promerogomb/Lanzadera-Electromagnetica/Memoria/Aux/EcsBlancas.pdf

Ley Integral de Amp`ere
I
B⃗ · d

⃗l = µ0Ienc

∇ · ⃗ E⃗ =

ρ
ϵ0

∇ · ⃗ B⃗ = 0

∇×⃗ E⃗ = −

∂B⃗
∂t ∇×⃗ B⃗ = µ0J⃗+µ0ϵ0

∂E⃗

∂t

∇×⃗ B⃗ = µ0J⃗+µ0ϵ0

| ∂E⃗
| ∂t →

I
| B⃗ ·d ⃗l = µ0Ienc

B = µ0µr

NI
L

= NI

=

lcarac

µ0µrSeff

= F/R

1

Rϕ =

(lc + lfe) − x

µ0 ∗ Sdisp

Rfe =

lfe

µ0µr ∗ Sfe

Rdisp c =

lc

µ0 ∗ Sdisp

Raire c =

lc − x

µ0 ∗ Sc

XR = Rϕ+Rfe+Rdisp c+Raire c → ϕ =

NI
PR

BT =

ϕ
ST

→ FT =

1
2

B²
T

∗ ST
µ0

Tsim = 25 ms Tstep = 1 ms → 25 steps

I(t = 0) = 3,5 A I(t ≥ 15 ms) = 0 A Vcoil = 13,1 V Rcoil = 3,65 Ω mbar = 0,019 kg vbar ini = 0 ms⁻¹

2

d(t) = 1
2

at² + v0t + d0 → d =

1
2

at² →

→ a =

2d
t

2 → F = ma

3
