promerogomb/Lanzadera-Electromagnetica/Memoria/Memoria/main.tex

% Paquetes
\documentclass[a4paper,11pt]{article}
\usepackage[utf8]{inputenc}
\usepackage{graphicx}
\usepackage{hyperref}
\usepackage{geometry}
\usepackage{ragged2e}
\usepackage{setspace}
\usepackage{anyfontsize}
\usepackage{tocloft}
\usepackage{titlesec}
\usepackage{parskip}
\usepackage{indentfirst}
\usepackage{textcomp}
\usepackage[spanish]{babel}
\usepackage{caption}
\usepackage[square,numbers]{natbib}
\usepackage{float}
\usepackage{enumitem}
\usepackage{amsmath}
\usepackage{amssymb}
\usepackage{matlab-prettifier}
\usepackage{xcolor}
\usepackage{array}
\usepackage{pdfpages}
\usepackage{listings}
\usepackage{colortbl}
\usepackage{multirow}
\usepackage{tabularx}
\usepackage{pdflscape}
\usepackage{afterpage}
\usepackage{arydshln}
\usepackage{fontawesome}
\usepackage{adjustbox}
\usepackage{background}
\usepackage{tikz}
\usepackage{placeins}

% Preámbulo
\geometry{
  a4paper,         % Paper size
  left = 3cm,        % Left margin
  right = 3cm,       % Right margin
  top = 2.5cm,         % Top margin
  bottom = 2.5cm       % Bottom margin
}

\setlength{\parindent}{2em}
\setlength{\parskip}{1em plus 0.5em minus 0.2em}
\captionsetup{font=normalsize}
\addto\captionsspanish{
  \renewcommand{\tablename}{Tabla}
  \renewcommand{\listtablename}{Índice de tablas}
}

\spanishdecimal{.}
\definecolor{maroon}{RGB}{128, 0, 0}

%% Definición estilo C:
\lstset{
  language=C,
  basicstyle=\ttfamily\small,
  keywordstyle=\color{blue},
  commentstyle=\color[rgb]{0,0.5,0},
  stringstyle=\color{red},
  numbers=left,
  numberstyle=\tiny\color{gray},
  stepnumber=1,
  numbersep=10pt,
  backgroundcolor=\color{white},
  showspaces=false,
  showstringspaces=false,
  showtabs=false,
  frame=single,
  tabsize=4,
  captionpos=b,
  breaklines=true,
  breakatwhitespace=false,
  title=\lstname,
  escapeinside={},
  morekeywords={setup, loop, pinMode, digitalWrite, delay, HIGH, LOW, INPUT, OUTPUT},
}

%% Estilos de letras
\newcommand{\boldcenteredtext}[1]{
  \begin{center}
    \textbf{\fontsize{12pt}{14pt}\selectfont #1}
  \end{center}
}
\newcommand{\largeboldcenteredtext}[1]{
  \begin{center}
    \textbf{\fontsize{16pt}{18pt}\selectfont #1}
  \end{center}
}
\newcommand{\boldrightalignedtext}[1]{
  \begin{flushright}
    \textbf{\fontsize{12pt}{14pt}\selectfont #1}
  \end{flushright}
}
\newcommand{\centeredtext}[1]{
  \begin{center}
    \fontsize{10pt}{12pt}\selectfont #1
  \end{center}
}

%% Apariencia referencias
\hypersetup{
  colorlinks=true,
  linkcolor=black,
  urlcolor=blue,
  pdfborder={0 0 0},
  citecolor=black
}

%% Índices
\renewcommand{\contentsname}{Índice de contenidos}
\renewcommand{\listfigurename}{Índice de figuras}
\renewcommand{\cftfigpresnum}{\figurename\ }
\renewcommand{\cftfigaftersnum}{:}
\setlength{\cftfignumwidth}{3em}
\renewcommand{\listtablename}{Índice de tablas}

% Documento
\begin{document}

\pagestyle{plain}

\thispagestyle{empty}
\input{portada.tex}

\newpage
\thispagestyle{empty}
\null

\newpage
\thispagestyle{empty}
\input{Agradecimientos.tex}

\newpage
\input{resumen.tex}

% Indice títulos
\newpage
\thispagestyle{empty}
\tableofcontents

% Indice figuras
\newpage
\thispagestyle{empty}
\listoffigures

% Indice tablas
\newpage
\thispagestyle{empty}
\listoftables

\addtocontents{toc}{\protect\setcounter{tocdepth}{3}}

\newpage
\input{Intro.tex}

\newpage
\input{ObjetivosMetodosMotivacion.tex}

\newpage
\input{MarcoTeorico.tex}

\newpage
\input{Analitico.tex}

\newpage
\input{Simulaciones.tex}

\newpage
\input{Prototipo.tex}

\newpage
\input{Resultados.tex}

\input{Practica.tex}

\newpage
\input{Conclusiones.tex}

\newpage
\begin{flushleft}
  \begingroup
    \section{Referencias}
    \renewcommand{\refname}{}
    \bibliographystyle{unsrt}
    \bibliography{referencias}
  \endgroup
\end{flushleft}

\newpage
\input{anexo1.tex}

\newpage
\input{anexo2.tex}

\includepdf[pages=-]{sensorDatasheet.pdf}
\includepdf[pages=1-5]{ssrDatasheet.pdf}

\end{document}
