promerogomb/Lanzadera-Electromagnetica/Memoria/Memoria/Agradecimientos.tex

Quiero dedicar este trabajo de final de grado a mis padres y a mi hermana. Ellos han sido una guía y un apoyo constante en mi vida, formándome como persona y proporcionándome la oportunidad de cursar la carrera de Ingeniería Eléctrica. Sin su esfuerzo, sacrificio y cariño incondicional, no habría sido posible alcanzar este logro. Gracias por todo el apoyo y la dedicación que habéis mostrado a lo largo de mi vida y en especial durante estos años de estudio universitario.

También quisiera agradecer a mis profesores Ibón Elosegui y Jose Macayo, sin los cuales no podría haber llevado a cabo este interesante proyecto. A Ibón por sus valiosas enseñanzas en el campo de la electricidad y las muchas enseñanzas vitales. Y a Jose por su interés continuo y su predisposición a ayudar siempre. Sois el pilar de la ingeniería eléctrica en tecnun, y sin ninguna duda habéis tenido un papel imprescindible en el desarrollo de mi vocación.
