promerogomb/Lanzadera-Electromagnetica/Memoria/Memoria/main.pdf

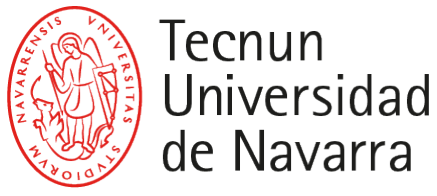
[picture p47: figure]

Proyecto Fin de Grado

## INGENIERÍA ELECTRICA ´

## Diseño y desarrollo de una lanzadera electromagnética

Pedro José Romero Gombau

Donostia-San Sebastián, mayo 2024

Po Manuel Lardizabal, 13. 20018 Donostia-San Sebastián, Gipuzkoa Tel. 943 219 877 · Fax 943 311 442 · www.tecnun.es

## Resumen

Este trabajo de fin de grado trata acerca del diseño y la implementación de una lanzadora electromagnética, centrándose en el uso de ANSYS Maxwell para la simulación y el desarrollo de un prototipo funcional. Si bien el campo de la tecnología de las lanzadoras electromagnéticas está bien establecido, el objetivo principal de este proyecto es el diseño de una práctica universitaria en la que los alumnos dispongan de las fórmulas necesarias para optimizar la geometría y alimentación de la bobina y logren una mayor velocidad y fuerza de lanzamiento del proyectil. Los métodos empleados incluyen la creación de geometría en ANSYS Maxwell y simulaciones transitorias para analizar el comportamiento de la bobina, con énfasis en los parámetros dinámicos del proyectil. Además, se realizarán cálculos analíticos manuales para derivar relaciones electromagnéticas que rigen la interacción entre la bobina y el proyectil. En resumen, esta tesis presenta una exploración exhaustiva de las técnicas de diseño y simulación de una lanzadera electromagnética, con un enfoque en el aprendizaje de ANSYS Maxwell y la optimización de la geometría de la bobina para mejorar el rendimiento del proyectil.

Palabras clave:Lanzadera electromagnética, ANSYS Maxwell, Simulación, Prototipo, Optimización.

## Abstract

This undergraduate thesis focuses on the design and implementation of an electromagnetic launcher, emphasizing the use of ANSYS Maxwell for simulation and the development of a functional prototype. Although the field of electromagnetic launcher technology is well-established, the primary objective of this project is to design a university practical exercise in which students have the necessary formulas to optimize the geometry and power supply of the coil, achieving higher speed and force in projectile launch. The methods employed include creating geometry in ANSYS Maxwell and transient simulations to analyze the coil’s behavior, with an emphasis on the dynamic parameters of the projectile. Additionally, manual analytical calculations will be conducted to derive electromagnetic relationships governing the interaction between the coil and the projectile. In summary, this thesis presents a comprehensive exploration of the design and simulation techniques for an electromagnetic launcher, focusing on learning ANSYS Maxwell and optimizing coil geometry to improve projectile performance.

Key words:Coilgun, ANSYS Maxwell, Simulation, Prototype, Optimization.

## Índice

1. Introducción | 8
2. Marco teórico | 11
3. Desarrollo | 17
4. Resultados | 25
5. Discusión y conclusiones | 26

## Índice de figuras

1. | Cañón de Gauss. Imagen tomada de http://www.coilgun.eclipse.co.uk/ . . | 8
2. Ecuaciones de Maxwell.[7] | 11
3. Visualización del campo magnético de un conductor. Elaboración propia. . 12
4. Curva C⃗ para la cual realizaremos los cálculos. Imagen tomada de https://artpictures.club/autumn-
2023.html | 12
5. Visualización del campo magnético de una bobina energizada. Imagen tomada de https://ece.northeastern.edu/fac-ece/nian/mom/electromagnets.html. 14
6. Esquema cualitativo de la lanzadera electromagnética. Elaboración propia. 14
7. Esquema de una bobina con un core ferromagnético y su circuito magnéti-
co equivalente. Elaboración propia | 16
8. Esquema geométrico del sistema. Elaboración propia | 18
9. Secciones del sistema con una vista de planta. Elaboración propia | 18
10. Circuito magnético del sistema. Elaboración propia | 19
11. Aplicación de cálculos de MATLAB. Elaboración propia | 20
12. Geometría de la barra y bobina en 2D. Elaboración propia | 21
13. Mallado de la barra y bobina en 2D. Elaboración propia | 22
14. Detalle del mallado de la barra y bobina en 2D. Elaboración propia. . . . 22
15. Visualización de los campos magnéticos con la bobina energizada y x =
2/10 ∗ hc. Elaboración propia | 23
16. Visualización de los campos magnéticos dentro del solenoide. Elaboración
propia | 23

## Índice de tablas

1. Fuerzas de atracción magnética en los diferentes ejes del espacio. Elabora-
ción propia | 24

## 1. Introducción

En el ámbito de la ingeniería y la física aplicada, las coilguns, también conocidas como lanzaderas electromagnéticas, representan una tecnología de creciente interés debido a su potencial en aplicaciones tanto industriales como militares. El concepto de las lanzaderas electromagnéticas se origina en el siglo XIX, cuando se empiezan a explorar las propiedades del electromagnetismo y sus potenciales aplicaciones. Uno de los nombres con los que uno se puede referir a esta tecnología es Cañones de Gauss, debido a que fue el matemático Carl Friedrich Gauss quién desarrolló en esta época las ecuaciones que regían el comportamiento del dispositivo. Sin embargo, no es hasta los tempranos años del siglo XX cuando se construye la primera lanzadera funcional, producto del ingenio del científico noruego Kristian Birkeland.[6]


Figura 1: Cañón de Gauss. Imagen tomada de http://www.coilgun.eclipse.co.uk/

Las principales aplicaciones de las lanzaderas electromagnéticas se encuentran en el ámbito militar, donde se utilizan para el lanzamiento de proyectiles a alta velocidad sin la necesidad de explosivos químicos. Esta tecnología ofrece ventajas significativas, como la reducción del desgaste mecánico y la capacidad de ajustar la fuerza de lanzamiento con precisión. Además, en el sector aeroespacial, las lanzaderas electromagnéticas se consideran una alternativa prometedora para el lanzamiento de satélites y otros objetos al espacio, debido a su eficiencia energética y menor impacto ambiental en comparación con los cohetes tradicionales. También encontramos varias aplicaciones en la industria, como por ejemplo en procesos de manufactura que requieren la propulsión de materiales a altas velocidades. También se están explorando aplicaciones en el campo de la medicina, como en dispositivos de resonancia magnética y aceleradores de partículas para tratamientos médicos avanzados. [5]

Para finalizar con la introducción, se presentará brevemente el funcionamiento básico de estos cañones. El objetivo físico de una lanzadera electromagnética es la creación de un campo magnético mediante el paso de una corriente eléctrica a través de una bobina de cobre. Cuando se aplica corriente a la bobina, se genera un campo magnético que ejerce una fuerza sobre el proyectil, generalmente una barra de material ferromagnético, a la que me referiré durante este proyecto como vástago. El proceso de aceleración comienza cuando la corriente eléctrica, controlada por un circuito electrónico, fluye a través de la bobina, creando un campo magnético que atrae el proyectil hacia el centro de la bobina. Antes de que los centros de la bobina y el vástago estén alineados, la corriente se corta, provocando que este último continúe su movimiento hacia adelante debido a su inercia. A lo largo de este documento, se desarrollarán con detalle los diferentes aspectos teóricos y constructivos de una lanzadera electromagnética, llegando a desarrollar un prototipo con el objetivo de preparar una práctica universitaria para el departamento de Ingeniería Eléctrica de Tecnun.

### 1.1. Objetivos y métodos

Exploraremos ahora los principales objetivos del proyecto, desglosando cada parte constituyente y su resultado esperado. El principal propósito de este trabajo es el diseño de una práctica universitaria que se pueda realizar durante el primer o segundo curso, con la idea de atraer a nuevos ingenierios hacia el campo de la electricidad. Para lograr este objetivo principal, el trabajo se dividirá en cuatro partes: desarrollo teórico, simulaciones, desarrollo de un prototipo y desarrollo de la práctica. Los objetivos y resultados esperados de cada parte son:

1. Desarrollo teórico: Este apartado tiene como objetivo explorar las fórmulas que describen el comportamiento del vástago dentro de la bobina cuando es alimentada con corriente continua. El desarrollo resultará en una serie de fórmulas que constituirán un modelo del sistema, así como un programa que las implemente en una aplicación de MatLAB®.
2. Simulaciones: Las simulaciones tienen como objetivo obtener otro modelo físico del sistema, utilizando el método de los elementos finitos a través del software ANSYS Maxwell®. El resultado esperado es un modelo paramétrico que permita introducir los valores de la geometría de la bobina y su alimentación, y devuelva los valores dinámicos del vástago. Se espera que estos resultados sean más precisos que los obtenidos mediante el desarrollo teórico y se pretende probar diferentes configuraciones hasta llegar a la más óptima.
3. Prototipo: Esta parte tiene como objetivo el diseño y desarrollo de un prototipo funcional de lanzadera que permita comparar los resultados teóricos con los físicos. Será necesario diseñar un circuito electrónico de control con Arduino® y un medio físico para sujetar y alimentar la bobina. El resultado esperado es un prototipo manejable y modular, con el cual se puedan probar diferentes configuraciones.
4. Desarrollo de la práctica: Con los resultados obtenidos en los apartados anteriores, se desarrollará un documento que presente un problema de optimización a resolver por los alumnos que realicen la práctica. Se fijarán los parámetros objetivos y se especificará los valores que pueden modificar, así como las relaciones entre ellos, definidas por las ecuaciones obtenidas en el desarrollo teórico (??).

### 1.2. Motivación

Trataré en este subapartado las motivaciones que han impulsado este proyecto y justifican el área de estudio del mismo. El desarrollo de este proyecto está justificado por los siguientes puntos, que van a ser las principales áreas de influencia de este trabajo de final de grado:

1. Vanguardia Tecnológica: La investigación y desarrollo en tecnologías como la tratada en este trabajo representan una oportunidad para estar a la vanguardia en el campo de la ingeniería electromagnética. Este proyecto permite explorar y comprender los principios fundamentales del electromagnetismo aplicados a un sistema real y funcional.
2. Aplicación de Conocimientos Teóricos: La creación de una lanzadera electromagnética requiere la aplicación de conocimientos avanzados en física, matemáticas e ingeniería eléctrica. Este proyecto proporciona un contexto práctico en el que tanto yo como alumno, como los futuros estudiantes que lo utilicen, emplearán teorías y conceptos aprendidos en las aulas para fortalecer su entendimiento de los fenómenos electromagnéticos a un nivel visual y palpable.
3. Desarrollo de Competencias Técnicas: La construcción de la lanzadera involucra diversas habilidades técnicas, desde el diseño y simulación en software especializado hasta la fabricación y prueba de placas electrónicas y prototipos funcionales. Este proceso mejora significativamente las competencias prácticas en el laboratorio, una habilidad esencial para cualquier ingeniero eléctrico.
4. Fomento de la Innovación Educativa: El desarrollo de este proyecto no solo busca aportar al conocimiento técnico, sino también servir como una herramienta educativa innovadora. La práctica universitaria diseñada a partir de este proyecto permitirá a los estudiantes experimentar directamente con la optimización de parámetros electromagnéticos, desarrollando habilidades críticas y fomentando una mentalidad innovadora.

Con esto queda justificada la realización de este proyecto de fin de grado, y podemos empezar a desarrollar el proceso de creación de la lanzadera electromagnética.

## 2. Marco teórico

En esta sección se desarrollarán los principios teóricos que permiten el funcionamiento de las lanzaderas electromagnéticas. Para entender estos principios, es esencial comprender los fundamentos del electromagnetismo, el concepto de bobina, su relación con la generación de campos magnéticos y la forma de modelar estos.

El electromagnetismo es una rama fundamental de la física que estudia las interacciones entre los campos eléctricos y magnéticos. Su desarrollo ha sido crucial para el avance de la tecnología, desde la generación y transmisión de electricidad hasta las comunicaciones inalámbricas. Aunque la raza humana conoce los fenómenos eléctricos y magnéticos desde la historia antigua, estos no fueron estudiados hasta el siglo XVII, y se consideraban fenómenos independientes hasta que Hans Christian Ørsted descubrió en 1820 que una corriente eléctrica puede generar un campo magnético. Mientras el físico danés preparaba los equipos para dar una conferencia en la Universidad de Copenhague, observó que la aguja de una brújula cercana se desviaba cuando la corriente fluía a través de un alambre conductor. Este accidental descubrimiento le llevó a publicar el artículo CIRCA EFFEC-TUM CONFLICTUS ELECTRICI IN ACUM MAGNETICAM, en el que se describieron los fenómenos electromagnéticos por primera vez, aunque de manera cualitativa. En la siguiente década, Ampère y Faraday describirían matemáticamente el descubrimiento de Ørsted, dando lugar al electromagnetismo como lo conocemos hoy en día. [3]

El trabajo de James Clerk Maxwell en la década de 1860 unificó estos descubrimientos en un marco teórico coherente. Maxwell formuló un conjunto de ecuaciones que describen cómo los campos eléctricos y magnéticos interactúan y se propagan. Estas ecuaciones, conocidas como las ecuaciones de Maxwell, son la base del electromagnetismo clásico.

∇ · ⃗ E⃗ =

ρ
ϵ0

∇ · ⃗ B⃗ = 0

∇ × ⃗ E⃗ = −

∂B⃗
∂t | ∇ × ⃗ | B⃗ = µ0J⃗ + µ0ϵ0

∂E⃗

∂t

Figura 2: Ecuaciones de Maxwell.[7]

En el caso de este proyecto, la ley de Maxwell de mayor interés es la de Ampère. Esta ley es la que define la relación entre un campo magnético y uno eléctrico, y partir de las ecuaciones anteriores se puede definir la ley integral de Ampère como:

”La integral de línea del campo magnético B alrededor de un lazo cerrado es igual a µ0 multiplicado por la corriente total Ienc que pasa a través de cualquier superficie delimitada por el lazo. Matemáticamente, esto se expresa como:
I

∂S

B · dl = µ0Ienc

donde µ0 es la permeabilidad del vacío.”


Figura 3: Visualización del campo magnético de un conductor. Elaboración propia.

Una vez entendido el comportamiento en un conductor, el siguiente paso es analizar el componente principal de la lanzadera: la bobina. Una bobina, o solenoide, es un conductor enrollado de manera cilíndrica alrededor de un núcleo de algún material. El número de vueltas que da el conductor alrededor del núcleo se define como espiras y se denota como N, y el núcleo posee un parámetro físico llamado permeabilidad relativa µr, que indica su capacidad para permitir el paso del flujo magnético. Se llegará a continuación a una expresión para el campo magnético alrededor de un solenoide. Para ello, partiremos de la ley integral de Ampère y consideraremos un solenoide con N espiras y longitud l, por el cual pasa una corriente I. Elegimos una trayectoria rectangular C⃗ que va parcialmente dentro y fuera del solenoide, la cual es conveniente porque simplifica los cálculos del campo magnético.

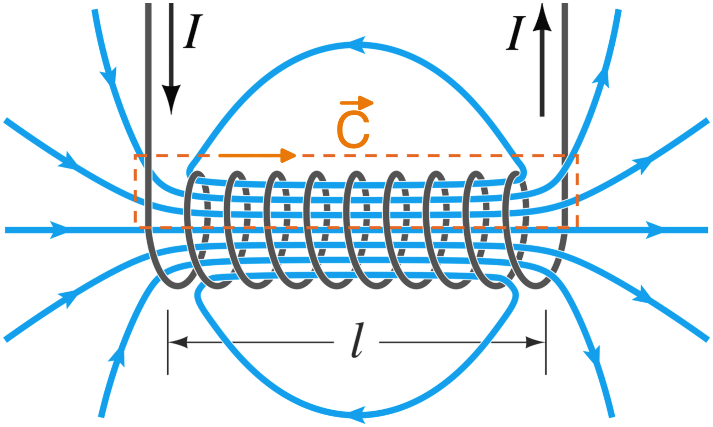
[picture p48: figure]

Figura | 4: | Curva | C⃗ | para | la | cual | realizaremos | los | cálculos. | Imagen | tomada | de
https://artpictures.club/autumn-2023.html.

La integral de línea del campo magnético B en la trayectoria rectangular C⃗ se puede dividir en cuatro segmentos:

Dentro del solenoide, paralelo al eje del solenoide, longitud l.

Fuera del solenoide, paralelo al eje del solenoide, longitud l.

Dos segmentos perpendiculares al eje del solenoide, cada uno de longitud w.

Debido a la simetría y a que el solenoide es muy largo, asumimos que el campo magnético fuera del solenoide es despreciable, y el campo dentro es uniforme y paralelo al eje del solenoide. Así, la integral se simplifica a:

I

c

B⃗ ⃗dl = Bl

Analizando ahora la corriente encerrada total, se observa que será igual a la corriente que fluye por las N espiras:

Iencerrada = NI

En una longitud cualquiera, l, se puede hablar de una densidad de espiras igual a n =

N
l

, por lo que en la curva C⃗ tendremos:

Iencerrada = nIl

Con lo que se obtien los dos términos de la ecuación integral de Ampère, por lo que podemos igualar:

Bl = µ0nIl → B = µ0nI ∀n =

N
l

→ B = µ0

NI
l

Que es la expresión para la inducción electromagnética en un solenoide.

El siguiente punto de interés es la forma del campo magnético del solenoide. La geometría del mismo juega un papel crucial en la distribución del campo magnético. Debido a su forma cilíndrica y a la disposición de las espiras, el campo magnético generado en el interior del solenoide es casi uniforme y paralelo al eje del cilindro, variando solo en los extremos donde se curva hacia el núcleo para cumplir la ley de Gauss para el campo magnético (∇B = 0). Esta uniformidad del campo magnético es una característica deseable en muchas aplicaciones, como en el diseño de inductores o transformadores. En nuestro caso, la uniformidad del campo nos va a permitir acelerar el proyectil de la lanzadera de manera rectilínea hacia el centro de la bobina.[7] [2][8].

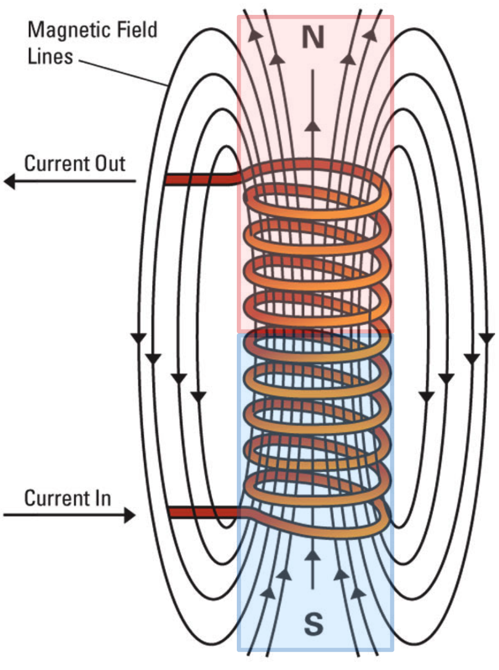
[picture p49: figure]

Figura 5: Visualización del campo magnético de una bobina energizada. Imagen tomada de https://ece.northeastern.edu/fac-ece/nian/mom/electromagnets.html.

La forma en que este fenómeno será aprovechado para construir la lanzadera consiste en colocar un proyectil de material ferromagnético en el extremo de una bobina energizada, el cual será atraído hacia el centro debido al campo magnético. Justo cuando los centros del proyectil y la bobina se encuentren alineados, la corriente se interrumpirá, evitando que el proyectil siga siendo atraído por el electroimán y permitiéndole avanzar por inercia. Esto se logrará mediante un circuito electrónico que energizará la bobina durante el tiempo necesario para que el proyectil alcance la máxima velocidad posible. Este circuito será desarrollado en la sección de prototipo (3.3).

La figura 7 a continuación es un esquema sencillo en el que se visualizan las partes esenciales de una lanzadera electromagnética:

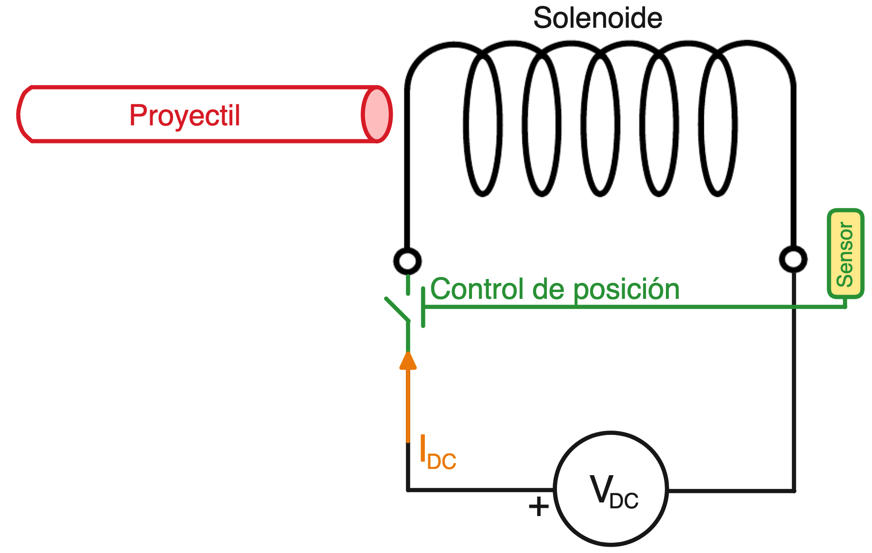
[picture p50: figure]

Figura 6: Esquema cualitativo de la lanzadera electromagnética. Elaboración propia.

Antes de finalizar el marco teórico, es necesario definir la manera en la que se va a representar el sistema de manera computable. Para ello, se utiliza el análisis del circuito magnético del sistema. Un circuito magnético se puede analizar de manera análoga a un circuito eléctrico, utilizando los conceptos de reluctancia, fuerza magnetomotriz (FMM) y flujo magnético. A continuación, se describen estos conceptos y sus relaciones entre sí.

Reluctancia La reluctancia R es una medida de la oposición que ofrece un material al paso del flujo magnético. Es análoga a la resistencia en un circuito eléctrico y su unidad es [H⁻¹
]. La fórmula para la reluctancia es:

R =

lcar
µ0µrA

Donde:
µ0µr es la permeabilidad del material [NA²
].
lcar es la longitud característica del camino magnético [m].
A es el área de la sección transversal del camino magnético [m²
].

Fuerza Magnetomotriz (FMM) La fuerza magnetomotriz F es la fuerza que impulsa el flujo magnético a través de un circuito magnético. Es análoga a la fuerza electromotriz (fem) en un circuito eléctrico y su unidad es [A−v]. La FMM se define como:

F = NI

Donde:
N es el número de vueltas de la bobina [v].
I es la corriente de alimentación de la bobina [A].

Flujo Magnético El flujo magnético ϕ es la cantidad de campo magnético que pasa a través de una superficie. Es análogo a la corriente eléctrica y su unidad es [W b]. Se define como:

ϕ = BA

Donde:
B es la densidad de flujo magnético [T].
A es el área de la superficie perpendicular al campo magnético [m²
].

Ley de Hopkinson La Ley de Hopkinson establece la relación entre la FMM, el flujo magnético y la reluctancia en un circuito magnético, de manera análoga a la Ley de Ohm en los circuitos eléctricos:

F = Rϕ

Como expresa la ley de Hopkinson, los conceptos de reluctancia, FMM y flujo magnético están interrelacionados en un circuito magnético. La FMM generada por una corriente que pasa a través de un devanado crea un flujo magnético que se opone a la reluctancia del material.[2][8]

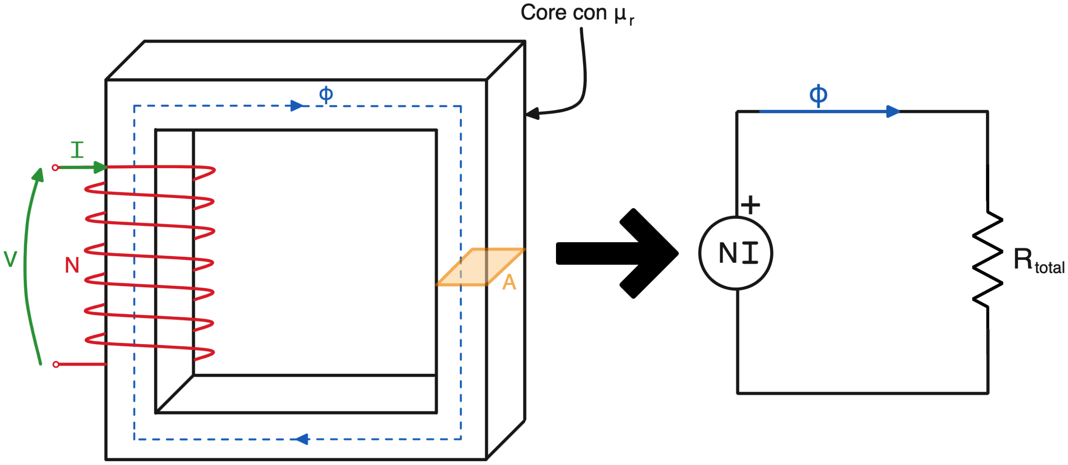
[picture p51: figure]

Figura 7: Esquema de una bobina con un core ferromagnético y su circuito magnético equivalente. Elaboración propia.

## 3. Desarrollo

En esta sección se detallarán los pasos llevados a cabo para la consecución del objetivo principal de este proyecto: el diseño y construcción de una lanzadera electromagnética. En los siguientes apartados, se describirán concisamente los procedimientos, herramientas y resultados obtenidos en cada una de estas fases del desarrollo.

### 3.1. Desarrollo teórico

En la sección de desarrollo teórico trataré de proporcionar un procedimiento mediante el cual los alumnos que realicen la práctica sean capaces de optimizar la velocidad y fuerza del proyectil a partir de los parámetros eléctricos y geométricos que definen el sistema. Estos parámetros de entrada serán:

Parámetros geométricos:

a. rcext y rcint: radios exterior e interior de la bobina, respectivamente.
b. lc: altura de la bobina.
c. rfe: radio del vástago.
d. lfe: longitud del vástago.
e. kdisp: parámetro multiplicador para obtener la sección de dispersión. La dispersión es la parte del flujo que abraza a la bobina y a la barra.

Parámetros eléctricos:

a. N: número de espiras.
b. Icc: corriente de alimentación del solenoide.
c. µfe: permeabilidad relativa del vástago ferromagnético.

El objetivo de este desarrollo es crear un programa en MATLAB al que se le proporcionen estos datos, y que calcule automáticamente la fuerza que experimentará el proyectil a través del circuito magnético del sistema. Como se muestra en la figura 5 el valor de B varía a lo largo del solenoide, por lo tanto, además de los parámetros constantes dados, será necesario parametrizar también la posición del vástago en cada momento (x en la figura 8) y calcular la fuerza que experimenta en cada una de esas posiciones. Se muesta a continuación el esquema que nos servirá de guía durante la creación del código, en el que se muestran todas las variables mencionadas anteriormente:


Figura 8: Esquema geométrico del sistema. Elaboración propia.

El primer paso será partir de las fórmulas del circuito magnético definidas en el 2 marco teórico y para ello la primera tarea es realizar un análisis de las diferentes reluctancias del sistema, con el objetivo de computar así la inducción magnética, la cual nos permitirá obtener la fuerza de atracción que experimenta el vástago, que según Nicolás Jerez [4] viene dada por la expresión:

F =

1
2

B² ∗ S
µ0

Teniendo clara la relación entre inducción y fuerza, el siguiente paso es definir claramente las diferentes áreas efectivas de los componentes del sistema para calcular las reluctancias, las cuales son:

Sc = π ∗ r

2
cext: Esta superficie se corresponde con la sección delimitada por el radio exterior de la bobina, y es el área efectiva del flujo encerrado en su interior.

Sfe = π ∗ r

2
fe: Esta superficie se corresponde con la sección delimitada por el radio del vástago.

Sdisp = π ∗ rdisp ∀rdisp = kdisprc: Esta superficie se corresponde con el área de dispersión de flujo.


Figura 9: Secciones del sistema con una vista de planta. Elaboración propia.

Teniendo en cuenta las fórmulas en la sección del marco teórico (2) y lo expuesto en la figura 9, podemos concluir que existen cuatro principales reluctancias en el sistema de la figura 8:

Rdisp c =

hc
µ0∗Sdisp

: Se corresponde a la reluctancia del aire que abraza la bobina. Esta reluctancia es fija ya que las dimensiones del solenoide son constantes.

Rfe =

lfe
µ0∗µfe∗Sfe

: Se corresponde a la reluctancia de la barra. Esta reluctancia es fija ya que las dimensiones del vástago son constantes.

Rϕ =

(hc+lfe)−x

µ0∗Sdisp

: Se corresponde a la reluctancia del aire del camino más largo del flujo magnético, y es la que provoca que el campo del electroimán interactúe con el vástago. Es variable ya que la posición del vástago es variable y el camino se reduce con el tiempo.

Raire c =

hc−x
µ0∗Sc

: Se corresponde a la reluctancia del aire en el interior de la bobina. Es variable ya que la cantidad de aire disminuye con la posición del vástago.


Figura 10: Circuito magnético del sistema. Elaboración propia.

Con el circuito magnético definido, el siguiente paso es programar las relaciones presentadas en esta sección en MATLAB y graficar los resultados en función de la posición. El programa en MATLAB constará de tres secciones: definición, cálculos y graficación. El código está disonible en el anexo 1 MIRAR POR QUE NO PUEDO PONER REF AQUI. El producto de este código es una çalculadora”que devuelve la evolución de la fuerza con el parámetro x, y queda así:

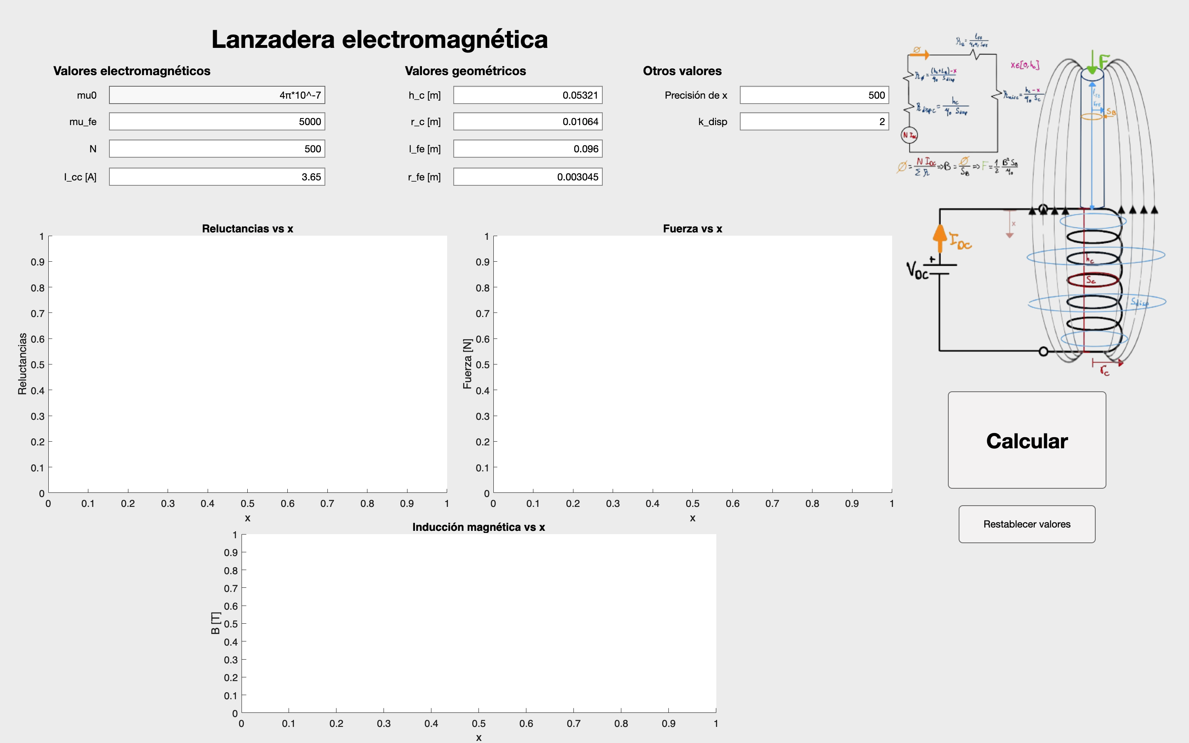
[picture p52: figure]

Figura 11: Aplicación de cálculos de MATLAB. Elaboración propia.

Los valores escritos en las variables del sistema que se pueden ver en la figura 11 se correponden con la bobina de ejemplo que se ha utilizado para crear el proyecto. Dicha bobina tiene la siguiente geometría:

µ0 = 4π × 10⁻⁷ | µfe = 5000 | N = 500
lfe = 0.096m | rfe = 0.003045m
hc = 0.05321m | rc = 0.01064m | rdisp = kdisp rc = 2 rc

### 3.2. Simulaciones

En esta sección, se describe el proceso de creación del modelo de la lanzadera electromagnética realizado utilizando ANSYS Maxwell. Este software de métodos finitos está especializado en el análisis de sistemas electromagnéticos. El objetivo de estas simulaciones es obtener una comprensión detallada del comportamiento del campo magnético generado por la bobina y su interacción con el proyectil ferromagnético en la lanzadera electromagnética. Se ha dividido el proceso en tres subapartados: creación de la geometría, simulaciones instantáneas y simulaciones transitorias. En la primera, se mostrará el proceso de creación de la geometría paramétrica en 2D y 3D, en la segunda y tercera se explicarán las condiciones de contorno y resultados de las simulaciones instantáneas y transitorias, respectivamente.

### 3.2.1. Geometría

El primer paso para realizar las simulaciones fue la creación de la geometría del sistema en ANSYS Maxwell. Para ello, se definieron las dimensiones y características de la bobina y el proyectil de manera paramétrica. Esto quiere decir que las dimensiones de los polígonos que conforman el modelo no son fijas, si no que están asociados a variables por lo que simular diferentes configuraciones se convierte en algo más sencillo. La geometría fue primeramente diseñada en 3D, pero también se obtuvo la sección central del archivo tridimensional para poder simular en 2D, lo que a priori permite menor tiempo de computación. Una vez creada la geometría, se definieron los diferentes materiales y las propiedades eléctricas y magnéticas. El material utilizado para los conductores del solenoide es cobre recocido, PVC para el soporte de la bobina y FALTA EL ACERO para el vástago. Con esto, se construye la geometría a continuación mostrada:

Geometría en 3D:

Mallado en 3D:

Geometría en 2D:


Figura 12: Geometría de la barra y bobina en 2D. Elaboración propia.

Mallado en 2D


Figura 13: Mallado de la barra y bobina en 2D. Elaboración propia.


Figura 14: Detalle del mallado de la barra y bobina en 2D. Elaboración propia.

La bobina se ha generado de la forma mostrada en las figuras anteriores debido a que representar un número de espiras del orden de 10² de manera helicoidal y con varias capas es muy complicado en ANSYS, ya que no es un entorno de diseño en 3D. Al crear un cilindro con dimensiones apropiadas, se puede indicar al software que lo trate como un solenoide, asignándole un número de espiras y una corriente de excitación. El programa distribuye uniformemente el campo generado por la corriente en todo el volumen, lo que resulta en una aproximación muy válida [1, p. 13].

### 3.2.2. Simulaciones instantáneas

ANSYS Maxwell permite realizar simulaciones de diferentes tipos, de las cuales tienen interés para este proyecto las magnetoestáticas y las transitorias. Como primera prueba para el modelo de la figura FIGURA3D, se realizó una simulación electroestática con una Icc = 3.5 A para poder observar los campos magnéticos del sistema, resultando en la siguiente figura:


Figura 15: Visualización de los campos magnéticos con la bobina energizada y x = 2/10 ∗ hc. Elaboración propia.

Vemos que se puede apreciar perfectamente la forma descrita en las figuras 4 y 5, curvándose en los extremos del sistema pero permaneciendo bastante uniforme a lo largo de hc. Se muestra a continuación un detalle de los campos únicamente dentro de la bobina con la barra en la posición de la figura 15:

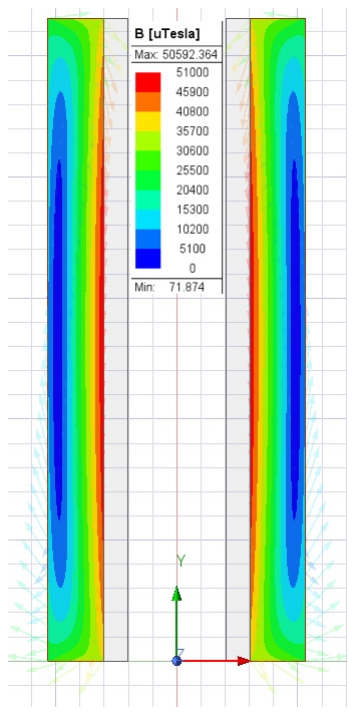
[picture p53: figure]

Figura 16: Visualización de los campos magnéticos dentro del solenoide. Elaboración propia.

Además de visualizar los campos, ANSYS Maxwell permite añadir distintas medidas a la simulación, entre las que se encuentra la fuerza de atracción magnética. Realizando la simulación de nuevo para la configuración en 3D, se obtiene que la fuerza es igual a:

| Fx | Fy | Fz | Ftot
FANSY S | Data 2 | Data 3 | Data 4 | Data 5

Tabla 1: Fuerzas de atracción magnética en los diferentes ejes del espacio. Elaboración propia.

### 3.3. Prototipo

## 4. Resultados

## 5. Discusión y conclusiones

## Referencias

[1] ANSOFT. ANSOFT Maxwell 3D V15 User Guide, 2012. URL https://ansoft-maxwell.narod.ru/en/CompleteMaxwell3D_V15.pdf. Accedido: 2024-06-22.
[2] D. J. Griffiths. Introduction to Electrodynamics, 2005.
[3] IEEE Spain. Doscientos aniversario
de Oersted y el descubrimiento del electromagnetismo. URL https://ieeespain.org/doscientos-aniversario-oersted-y-el-descubrimiento-del-electromagnetismo/. (https://ieeespain.org/doscientos-aniversario-oersted-y-el-descubrimiento-del-electromagnetismo/) Accedido: 24-06-2024.
[4] N. Jerez. Problemas de Máquinas Electricas ´ | , 2016. URL

https://www.researchgate.net/profile/Nicolas-Jerez-3/. Accedido: 2024-06-04.

[5] R. Kaye, B. Turman, and S. Shope. Applications of coilgun electromagnetic propulsion technology, 08 2002. URL https://ieeexplore.ieee.org/abstract/document/1189573. Accedido: 05-06-2024.
[6] V. K. Sai Chaithanya. A Review on Technological Advancement in Electromagnetic Coil Gun System, 2018. URL https://www.ijert.org/. Accedido: 05-06-2024.
[7] Purcell, Edward M. and Morin, David J. Electricidad y magnetismo, 2013.
[8] P. A. Tipler and G. Mosca. Physics for Scientists and Engineers. W. H. Freeman, New York, NY, 6th edition, 2008.

Anexo I. Código de MATLAB para la calculadora de fuerza.

En este anexo se presenta el código escrito para la calculadora expuesta en el apartado de desarrollo teórico 3.1. El código para la calculadora es ligeramente diferente ya que recibe las variables del campo Value de los componentes de la interfaz en lugar de desde un valor numérico fijo, pero el procedimiento que ejecuta es el mismo que se muestra a continuación:

1 | % Propiedades electromagneticas
2 | mu0 = 4 * pi * 10^ -7; % Permeabilidad del vacio [H/m]
3 | mu_fe = 5000; % Permeabilidad relativa del hierro
4 | N = 500; % Numero de espiras
5 | I_c = 3.65; % Corriente de la bobina
6
7 | % Geometria
8 | h_c = 0.05321; % Longitud de la bobina [m]
9 | r_c = 0.01064; % Radio externo de la bobina [m]
10 | l_fe = 0.096; % Longitud del vastago [m]
11 | r_fe = 0.003045; % Radio del vastago [m]
12
13 | S_c = pi * r_c ^ 2; % Seccion de la bobina [m^2]
14 | S_bar = pi * r_fe ^ 2; % Seccion del vastago [m^2]
15 | S_disp = 2 * S_c ; % Seccion de dispersion [m^2]
16
17 | % Vectores espaciales
18 | num_points = 2000; % Numero de puntos
19 | x = linspace (0 , h_c , num_points ) ; % Region de movimiento
20
21 | % Definicion de los vectores magneticos
22 | R_dispc = zeros ( size ( x ) ) ;
23 | R_phi = zeros ( size ( x ) ) ;
24 | R_B = zeros ( size ( x ) ) ;
25 | R_airc = zeros ( size ( x ) ) ;
26 | R_total = zeros ( size ( x ) ) ;
27 | Phi = zeros ( size ( x ) ) ;
28 | B = zeros ( size ( x ) ) ;
29 | F = zeros ( size ( x ) ) ;
30
31 | % Calculos
32 | for i = 1: length ( x )
33 | % Calculo de reluctancias :
34 | R_dispc ( i ) = h_c / ( mu0 * S_disp ) ; % Reluctancia de
| dispersion de la bobina [H^ -1]
35 | R_B ( i ) = l_fe / ( mu_fe * mu0 * S_bar ) ; % Reluctancia
| del vastago [H^ -1]
36 | R_phi ( i ) = (( h_c + l_fe ) - x ( i ) ) / ( mu0 * S_disp ) ; %
| Reluctancia de dispersion [H^ -1]
37 | R_airc ( i ) = ( h_c - x ( i ) ) / ( mu0 * S_c ) ; % Reluctancia
| del aire dentro de la bobina [H^ -1]
38
39 | R_total ( i ) = R_dispc ( i ) + R_phi ( i ) + R_B ( i ) + R_airc (
| i ) ; % Reluctancia total [H^ -1]

40
41 | % Flujo [Wb]
42 | Phi ( i ) = ( N * I_c ) / R_total ( i ) ;
43
44 | % Induccion magnetica [T]
45 | B ( i ) = Phi ( i ) / S_bar ;
46
47 | % Fuerza en x(i) [N]
48 | F ( i ) = 0.5 * B ( i ) ^2 * S_bar / mu0 ;
49 | end
50
51 | % Graficas
52
53 | % Reluctancias R[H^ -1]
54 | figure ;
55 | hold on ;
56 | plot (x , R_dispc , 'r', ' DisplayName ', 'R_{ dispc }') ;
57 | plot (x , R_B , 'g', ' DisplayName ', 'R_{ bar}') ;
58 | plot (x , R_phi , 'b', ' DisplayName ', 'R_{phi }') ;
59 | plot (x , R_airc , 'b', ' DisplayName ', 'R_{ airc }') ;
60 | plot (x , R_total , 'k', ' DisplayName ', 'R_{ total }') ;
61 | xlabel (' Posicion del vastago [m]') ;
62 | ylabel (' Reluctancias [H^ -1] ') ;
63 | title (' Reluctancias vs posicion ') ;
64 | legend show ;
65 | legend (' Location ', 'best ') ;
66 | grid on ;
67 | hold off ;
68
69 | % Induccion magnetica B[T]
70 | figure ;
71 | plot (x , B , ' LineWidth ', 2) ;
72 | xlabel (' Posicion del vastago [m]') ;
73 | ylabel (' Induccion magnetica [T]') ;
74 | title (' Induccion magnetica vs posicion ') ;
75 | grid on ;
76
77 | % Fuerza [N]
78 | figure ;
79 | plot (x , F , ' LineWidth ', 2) ;
80 | xlabel (' Posicion del vastago [m]') ;
81 | ylabel ('Fuerza magnetica [N]') ;
82 | title ('Fuerza vs posicion ') ;
83 | grid on ;
