promerogomb/Lanzadera-Electromagnetica/Desarrollo analítico/Calculadora/Geometry.png

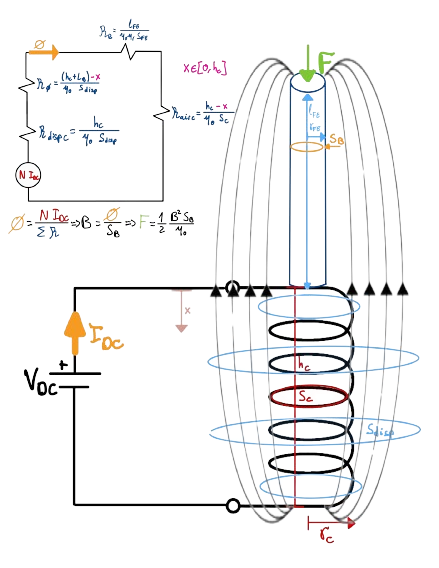
Desarrollo analítico/Calculadora/Geometry.png
