promerogomb/Lanzadera-Electromagnetica/Memoria/Memoria/FigurasMemoria/grafPosAnsysPractica.png

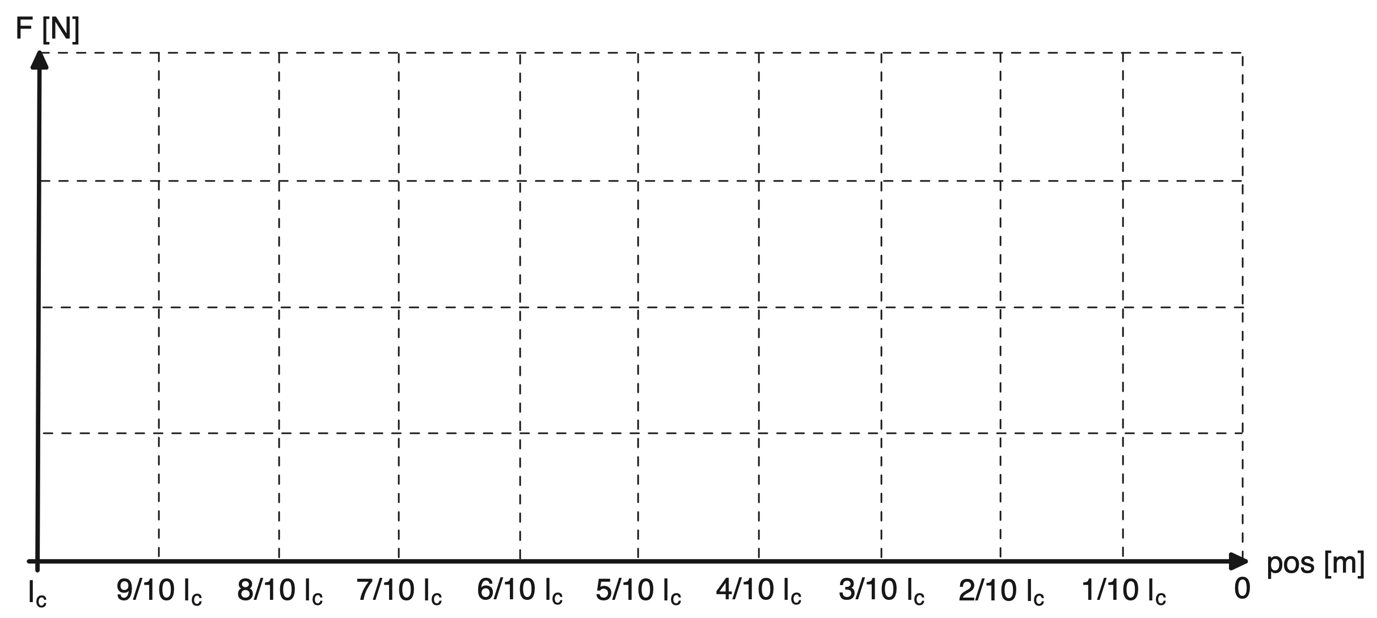
Memoria/Memoria/FigurasMemoria/grafPosAnsysPractica.png
