promerogomb/Lanzadera-Electromagnetica/Memoria/Memoria/FigurasMemoria/pcbFinal.jpg

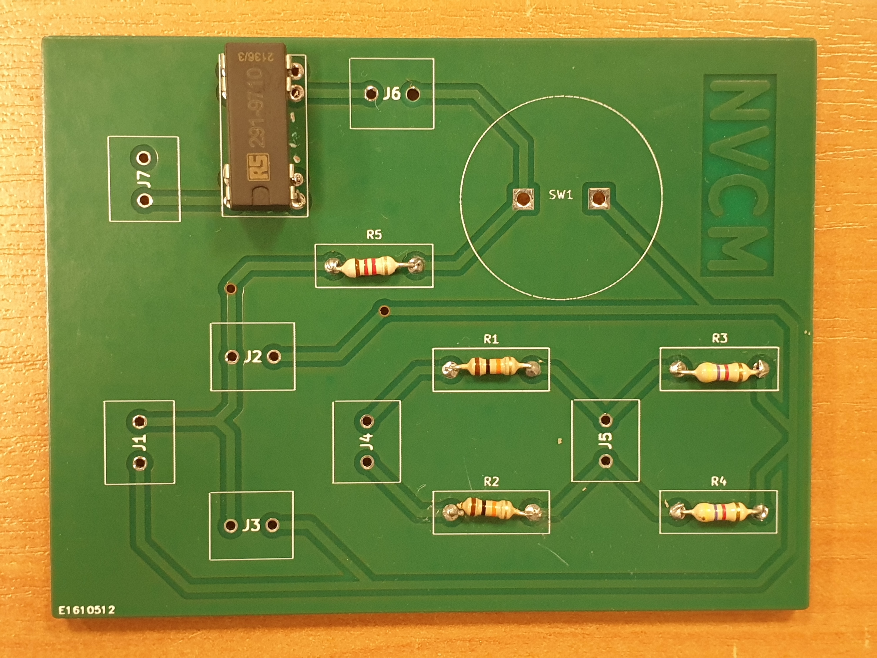
Memoria/Memoria/FigurasMemoria/pcbFinal.jpg
