promerogomb/Lanzadera-Electromagnetica/Prototipo/Bobinas.xlsx

 |  | d_wire | 0.08 | diam exterior | 2.67 | N | 500 | n | 7
 | Capas de la bobina de Óscar | d_n |  |  |  | w(vueltas/capa) | 72
 | d0 | 1.61 | l0
 | d1 | 1.77 | l1 | 400.36
 | d2 | 1.93 | l2 | 436.56 |  |  |  |  |  | Permeabilidad vacío | 0.0000013 | Masa vástago | 19.85427571
 | d3 | 2.09 | l3 | 472.75 |  |  |  |  |  | Permeabilidad relativa | 1.0000000 |  | Experimental | Calculada
 | d4 | 2.25 | l4 | 508.94 |  |  | A | V | R | Altura bobina [m] | 0.0531200 | Resistencia bobina [Ohm] | 3.65
 | d5 | 2.41 | l5 | 545.13 |  | Current method | 0.5 | 0.5 | 1 | Area rodeada [m^2] | 0.0000888
 | d6 | 2.57 | l6 | 581.32 |  | Resistividad | 1.68e-08 |  |  | Inductancia [mH] | 0.5253596
 | d7 | 2.73 | l7 | 617.51 |  | Longitud [m] | 29.92 |  |  |  |  | Tau [s] | 0.0001439341382
 | d8 | 2.89 | l_total [cm] | 3562.57 |  |  |  |  |  |  |  | 5 tau [s] | 0.0007196706908
 | d9 | 3.05
 |  |  |  |  |  | L1 | 35.63 |  |  | Fuerza [N] | 1.8
 |  |  |  |  |  | L2 | 29.92 |  |  | Área vástago [m^2] | 7.282231406e-06
 |  |  |  |  |  | L_media | 32.77 |  |  | Presión [Pa] | 247176.9846
 |  |  |  |  |  |  |  |  |  |  | 247176.98
 | Diámetro exterior bobina [cm] | Diámetro interior bobina [cm] | Diámetro interior PVC [cm] | Diámetro cable [cm] | Diámetro vástago [cm] | Longitud vástago [cm]
 | 2.127 | 1.207 | 0.808 | 0.05 | 0.609 | 9.6
Radios [m] | 0.010635 | 0.006035 | 0.00404 | 0.000250 | 0.003045 | 0.096
 | d0 | 1.207 | n | 10 | w | 75
 | d1 | 1.307 | l1 | 307.95 | Longitud cobre | 4139.83
 | d2 | 1.407 | l2 | 331.52
 | d3 | 1.507 | l3 | 355.08
 | d4 | 1.607 | l4 | 378.64
 | d5 | 1.707 | l5 | 402.20
 | d6 | 1.807 | l6 | 425.76
 | d7 | 1.907 | l7 | 449.33
 | d8 | 2.007 | l8 | 472.89
 | d9 | 2.107 | l9 | 496.45
 | d10 | 2.207 | l10 | 520.01
 | d11 | 2.307 | l11 | 543.57
 | d12 | 2.407 | l12 | 567.14
 | d13 | 2.507 | l13 | 590.70
 | d14 | 2.607 | l14 | 614.26
 | d15 | 2.707 | l15 | 637.82
 | d16 | 2.807 | l16 | 661.38
 | d17 | 2.907 | l17 | 684.95
 | d18 | 3.007 | l18 | 708.51
 | d19 | 3.107 | l19 | 732.07
 | d20 | 3.207 | l20 | 755.63
 | d21 | 3.307 | l21 | 779.19
 | d22 | 3.407 | l22 | 802.76
 | d23 | 3.507 | l23 | 826.32
 | d24 | 3.607 | l24 | 849.88
 | d25 | 3.707 | l25 | 873.44
