promerogomb/Lanzadera-Electromagnetica/Simulaciones/Results/Setup1Result/FieldAnim s1.gif

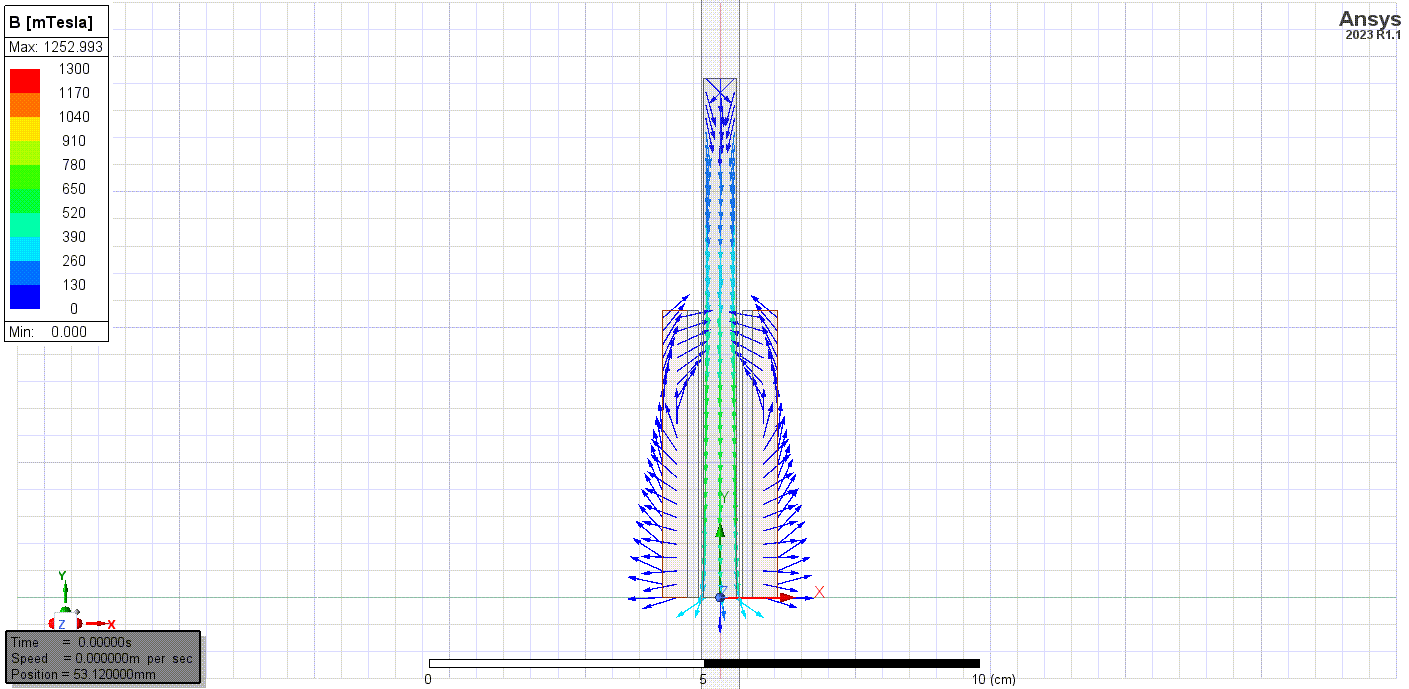
Simulaciones/Results/Setup1Result/FieldAnim s1.gif
