promerogomb/Lanzadera-Electromagnetica/Simulaciones/Results/Setup1Result/FluxIndVoltage s1.jpg

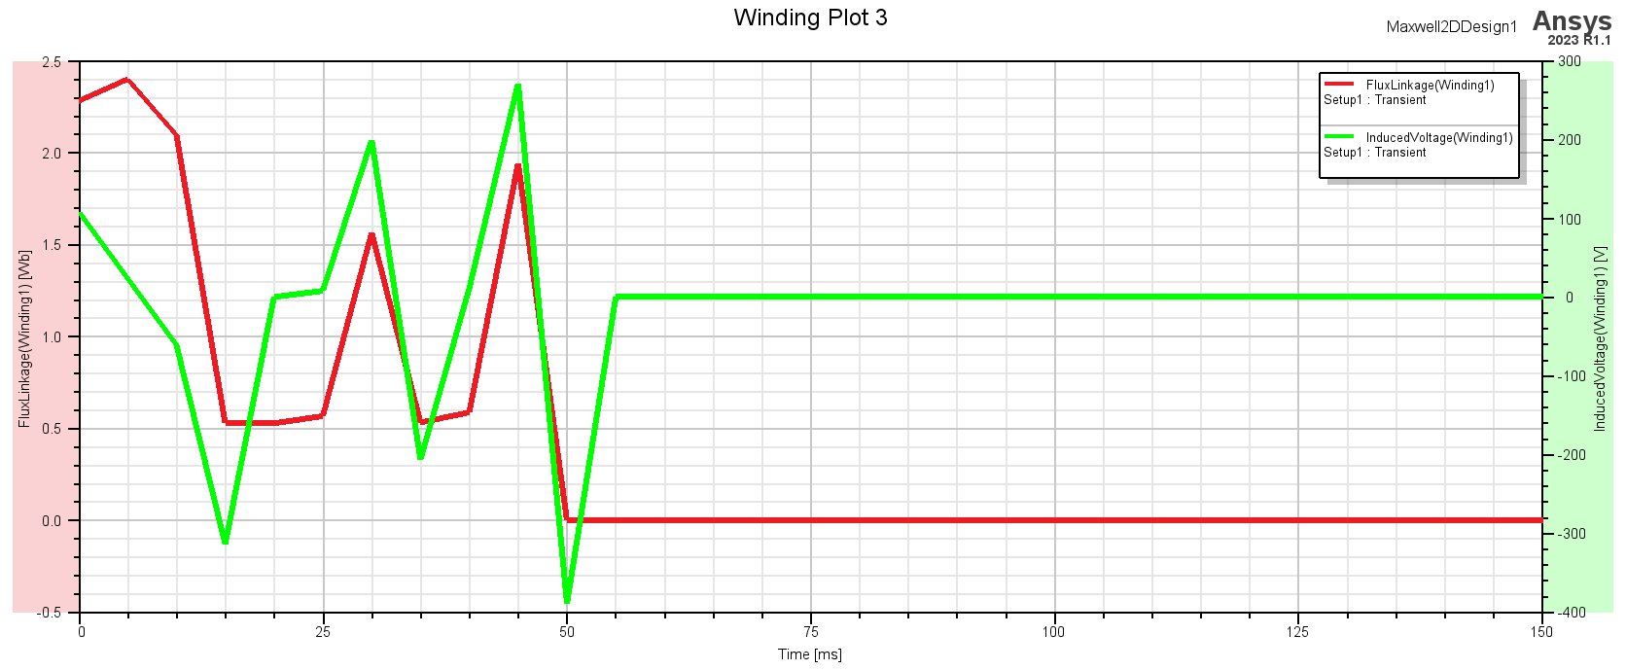
Simulaciones/Results/Setup1Result/FluxIndVoltage s1.jpg
