promerogomb/Lanzadera-Electromagnetica/Simulaciones/Results/Setup3Result/S3ForceCurrent.jpg

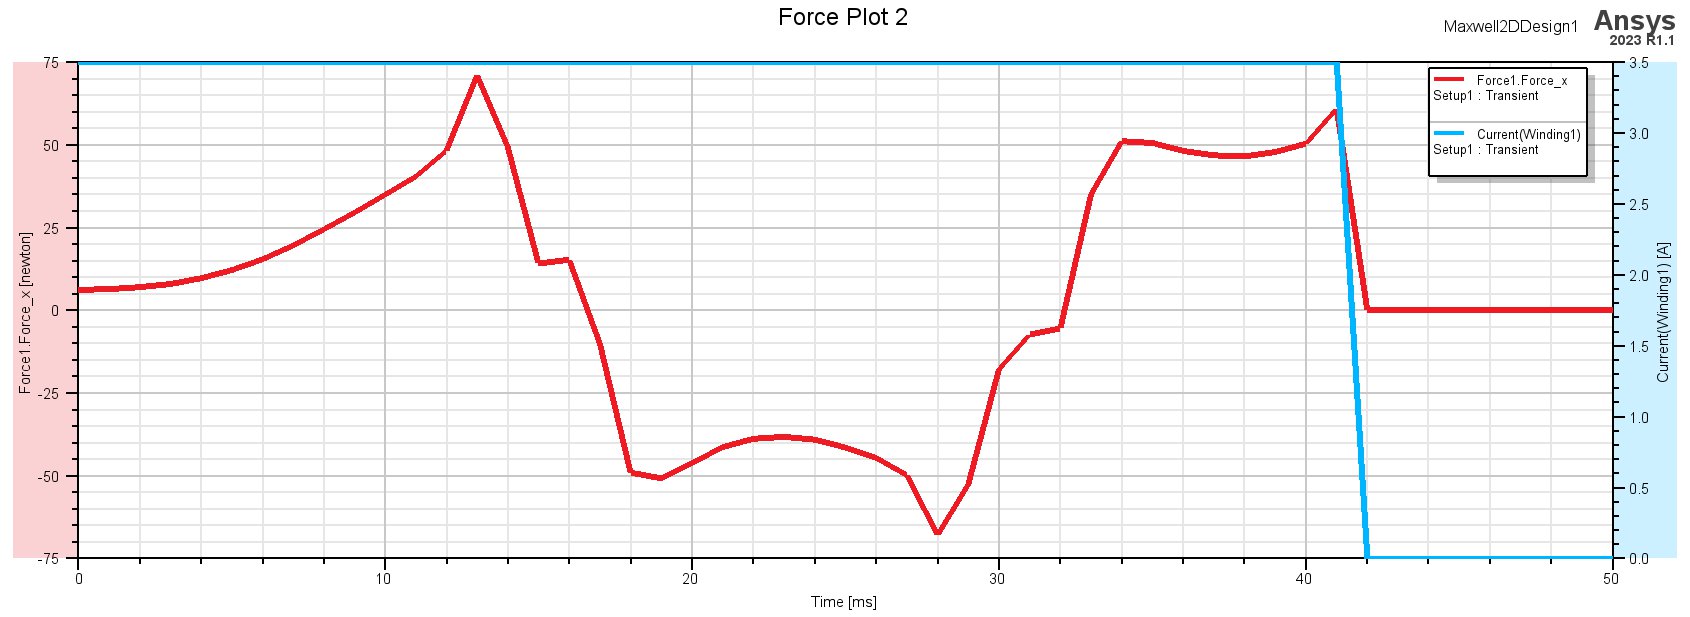
Simulaciones/Results/Setup3Result/S3ForceCurrent.jpg
