promerogomb/Lanzadera-Electromagnetica/Simulaciones/Results/Setup3Result/S3SpeedPosition.jpg

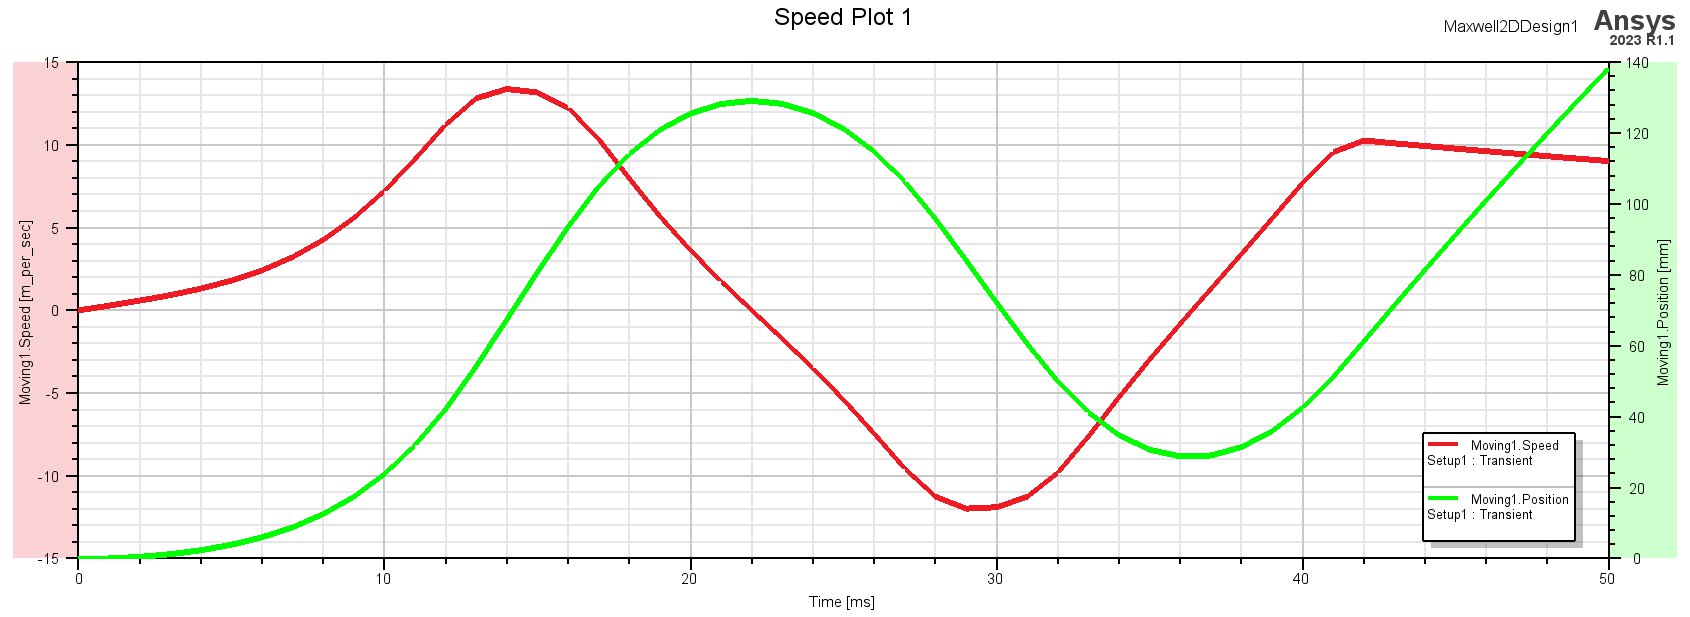
Simulaciones/Results/Setup3Result/S3SpeedPosition.jpg
