promerogomb/Lanzadera-Electromagnetica/Simulaciones/Results/Setup3Result/Setup3Anim.gif

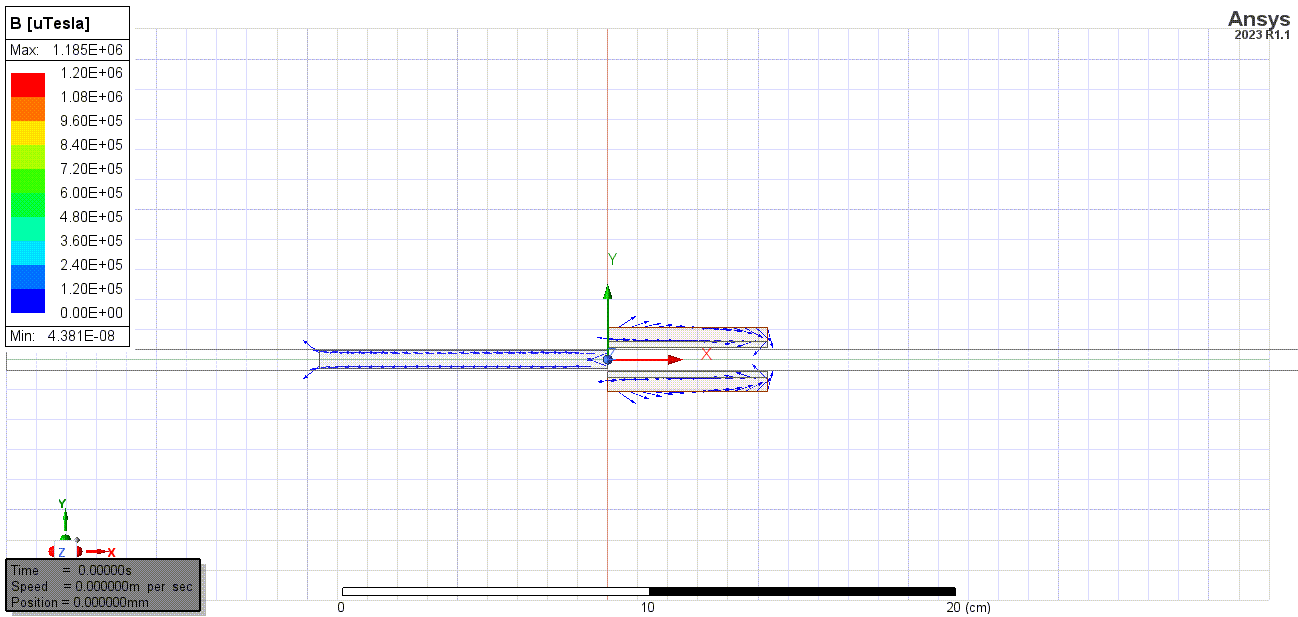
Simulaciones/Results/Setup3Result/Setup3Anim.gif
