promerogomb/Lanzadera-Electromagnetica/Simulaciones/Results/Setup4Result/anim4gif.gif

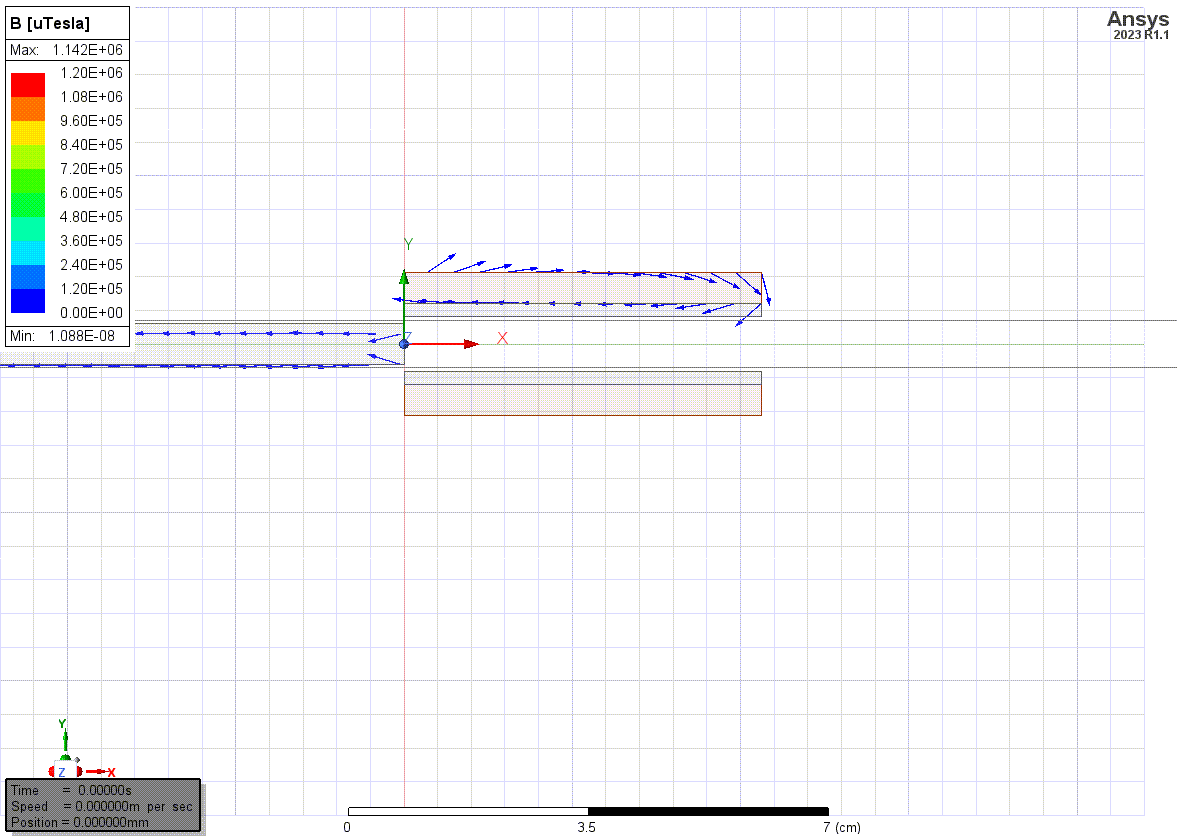
Simulaciones/Results/Setup4Result/anim4gif.gif
