promerogomb/Lanzadera-Electromagnetica/Prototipo/Fuerza experimental.xlsx

BOBINA | V [V] | I [A] | R [Ohm] | F [N]
Pequeña Óscar | 5 | 1.37 | 3.65 | 0.4
 | 8 | 2.21 | 3.62 | 1
 | 10 | 2.74 | 3.65 | 1.4
 | 13 | 3.5 | 3.71 | 1.8
 | 15 | 3.96 | 3.79 | 2.1
 | 18 | 4.9 | 3.67 | 2.5
 | 20 | 5.17 | 3.87 | 3.3
 | 23 | 6.1 | 3.77 | 3.7
 | 25 |  | #DIV/0!
 | 28 |  | #DIV/0!
 | 30 |  | #DIV/0!
