promerogomb/Lanzadera-Electromagnetica/Prototipo/Banco de pruebas/Velocidad experimental.xlsx

SSR
Lanzamiento | Bobina | Tensión [V] | Resistencia [Ohm] | Corriente [A] | Distancia [m] | Tiempo [ms] | Velocidad [ms^-1] | Velocidad media [ms^-1] | Aceleración [ms^-2] | Aceleración media [ms^-2]
1 | 500 oscar | 13.1 | 3.5 | 3.74 | 0.09 | 34 | 2.65 | 2.72 | 77.85 | 81.98
2 | 500 oscar |  |  |  |  | 37 | 2.43 |  | 65.74
3 | 500 oscar |  |  |  |  | 33 | 2.73 |  | 82.64
4 | 500 oscar |  |  |  |  | 32 | 2.81 |  | 87.89
5 | 500 oscar |  |  |  |  | 32 | 2.81 |  | 87.89
6 | 500 oscar |  |  |  |  | 32 | 2.81 |  | 87.89
7 | 500 oscar |  |  |  |  | 29 | 3.10 |  | 107.02
8 | 500 oscar |  |  |  |  | 33 | 2.73 |  | 82.64
9 | 500 oscar |  |  |  |  | 35 | 2.57 |  | 73.47
10 | 500 oscar |  |  |  |  | 35 | 2.57 |  | 73.47
11 | 500 oscar | 20 | 3.5 | 5.71 |  | 27 | 3.33 | 3.44 | 123.46 | 131.68
12 | 500 oscar |  |  |  |  | 26 | 3.46 |  | 133.14
13 | 500 oscar |  |  |  |  | 28 | 3.21 |  | 114.80
14 | 500 oscar |  |  |  |  | 27 | 3.33 |  | 123.46
15 | 500 oscar |  |  |  |  | 26 | 3.46 |  | 133.14
16 | 500 oscar |  |  |  |  | 26 | 3.46 |  | 133.14
17 | 500 oscar |  |  |  |  | 22 | 4.09 |  | 185.95
18 | 500 oscar |  |  |  |  | 28 | 3.21 |  | 114.80
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
