promerogomb/Lanzadera-Electromagnetica/Simulaciones/Results/Pics/BarFluxLines.png

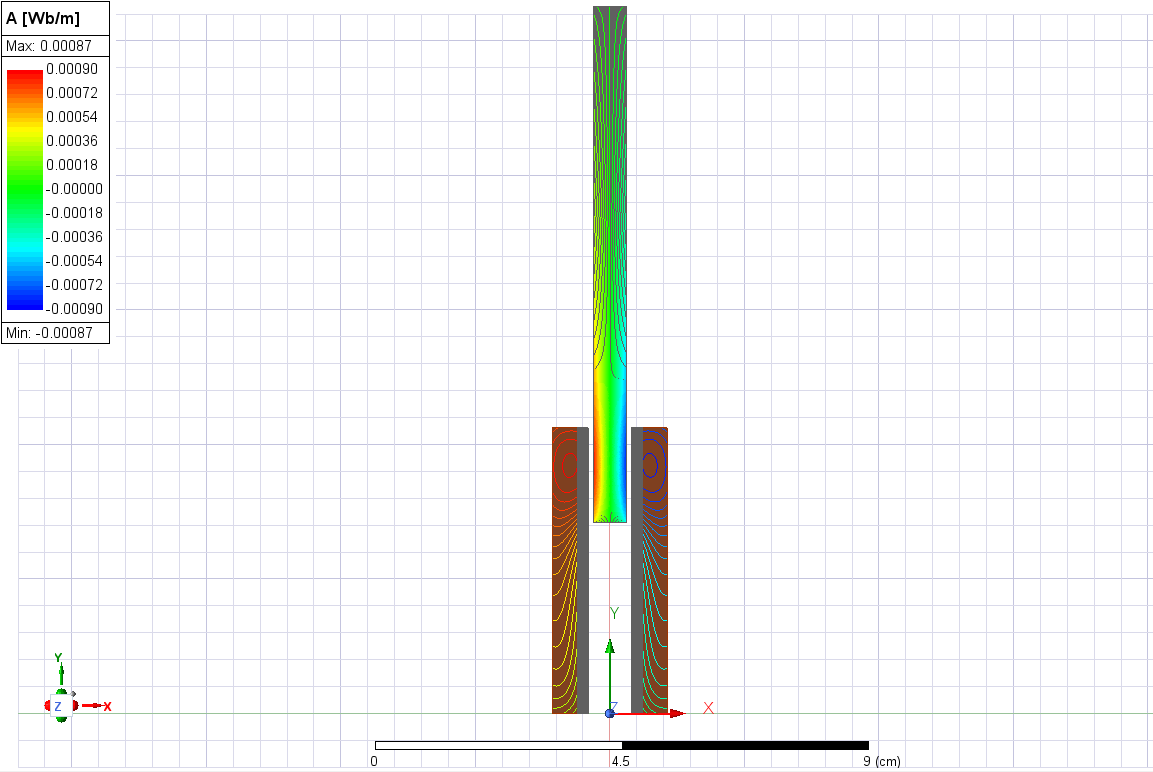
Simulaciones/Results/Pics/BarFluxLines.png
