promerogomb/Lanzadera-Electromagnetica/Simulaciones/Results/Pics/CoilBMag.png

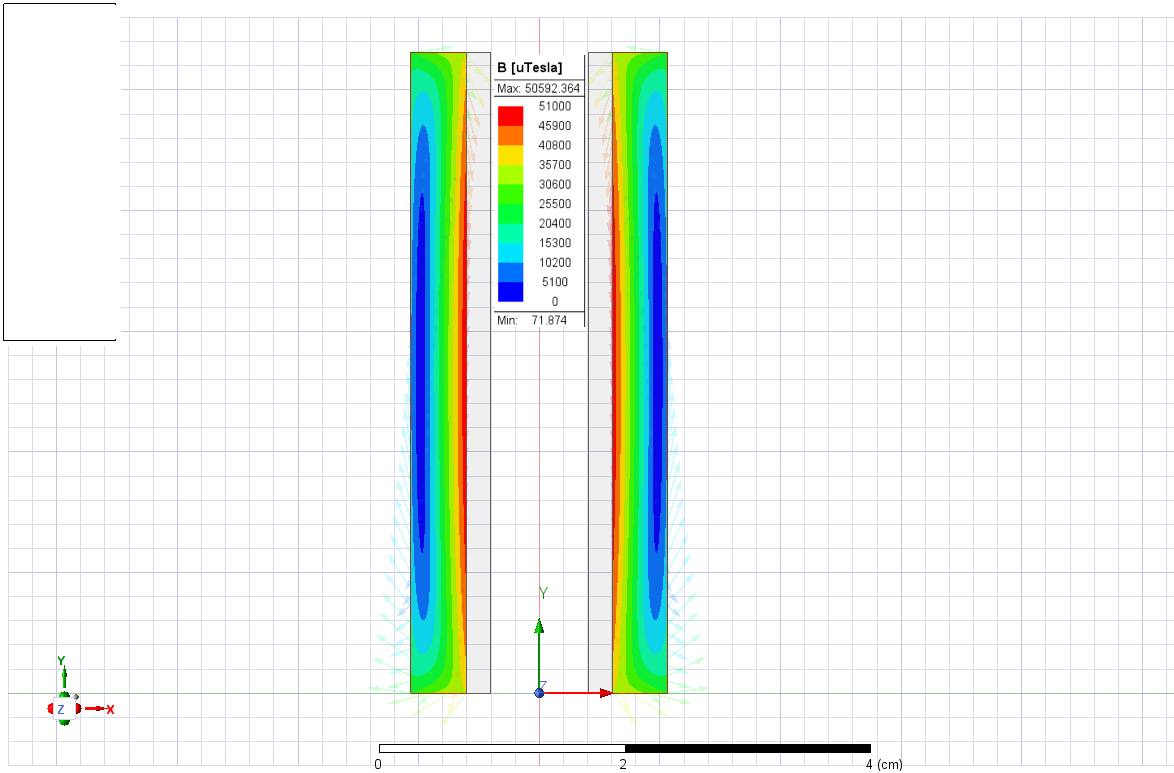
Simulaciones/Results/Pics/CoilBMag.png
