promerogomb/Lanzadera-Electromagnetica/Simulaciones/Results/Pics/CoilBVector.png

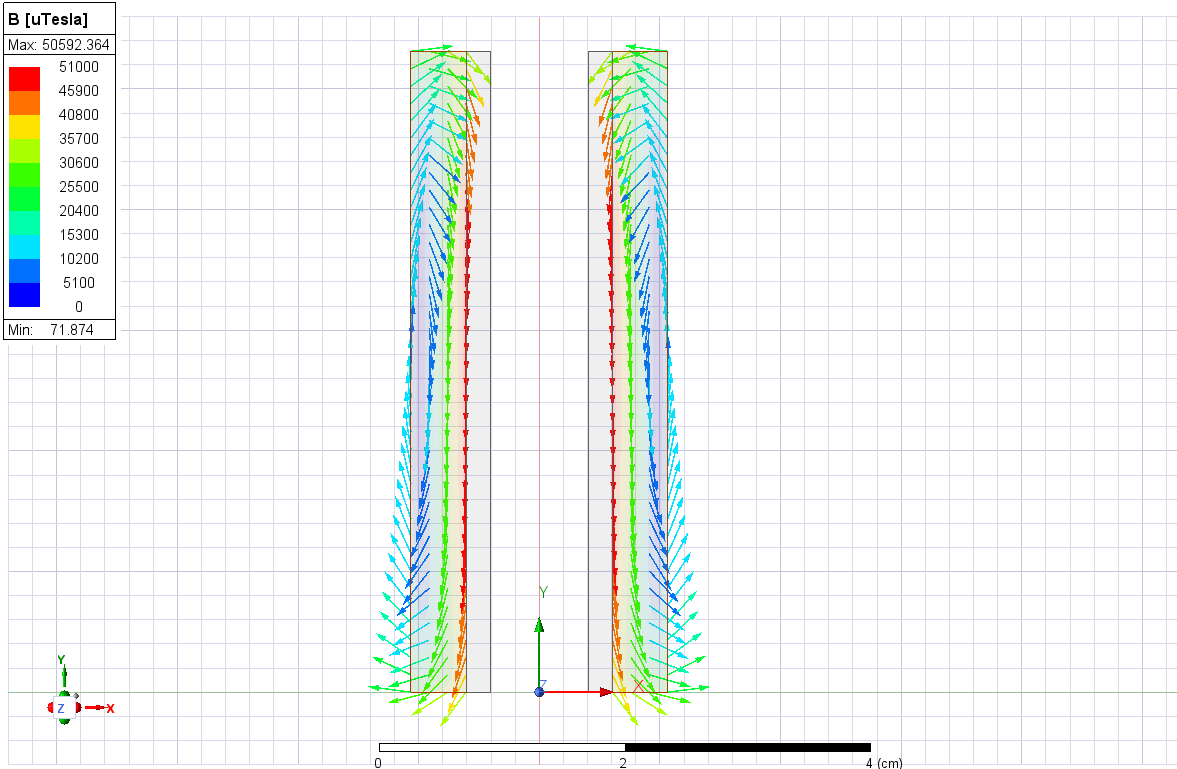
Simulaciones/Results/Pics/CoilBVector.png
