promerogomb/Lanzadera-Electromagnetica/Simulaciones/Results/Pics/CoilFluxLines.png

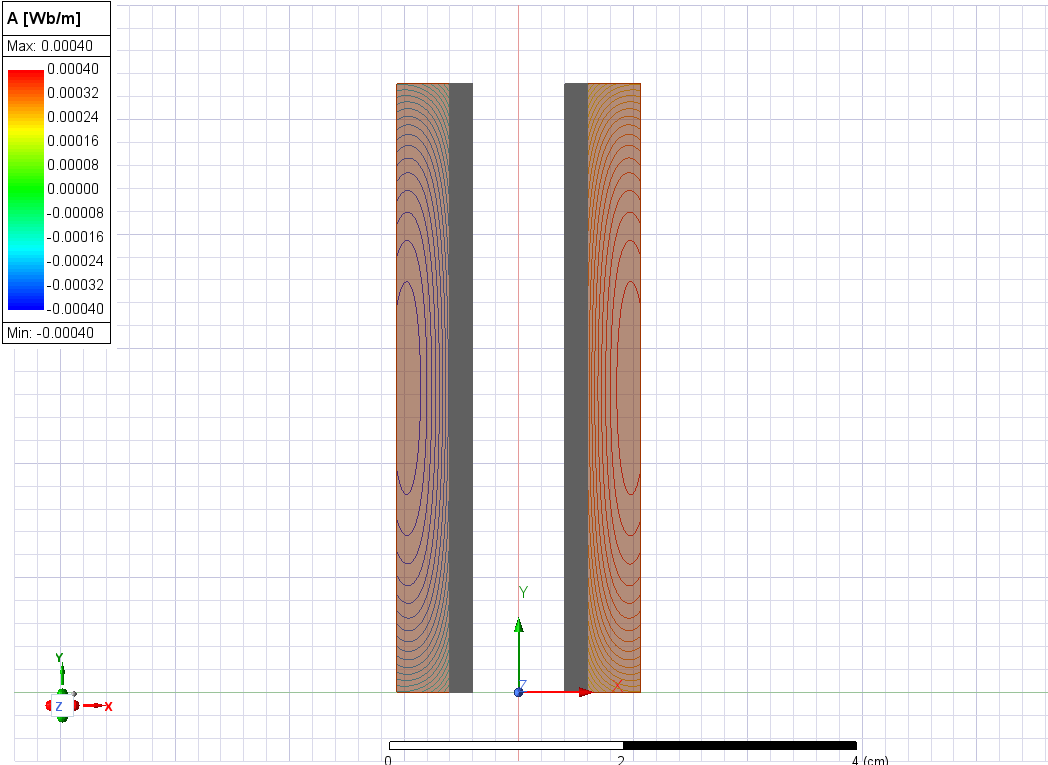
Simulaciones/Results/Pics/CoilFluxLines.png
