promerogomb/Lanzadera-Electromagnetica/Simulaciones/Results/Pics/CoilGeom.png

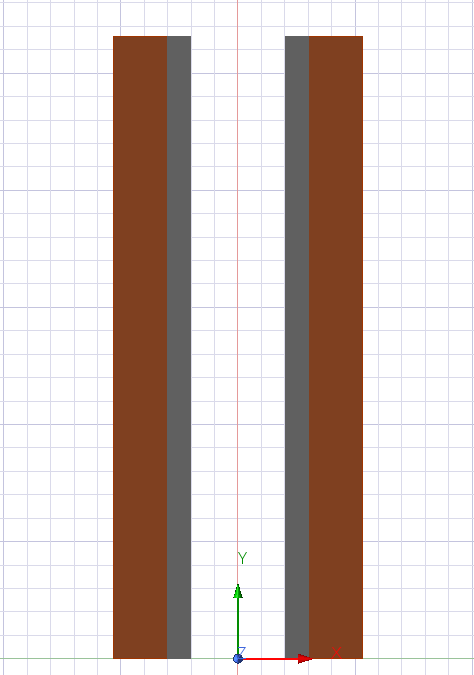
Simulaciones/Results/Pics/CoilGeom.png
