promerogomb/Lanzadera-Electromagnetica/Simulaciones/Results/Pics/CoilMeshDetail.png

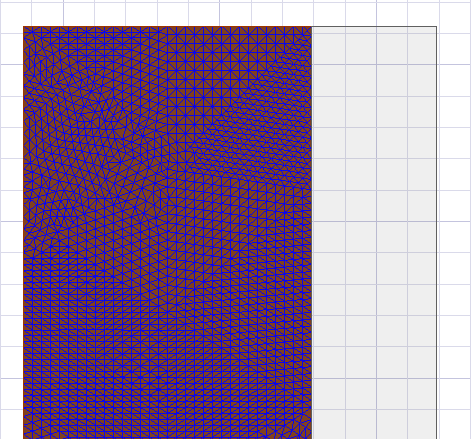
Simulaciones/Results/Pics/CoilMeshDetail.png
