promerogomb/Lanzadera-Electromagnetica/Simulaciones/Results/Pics/fields1.PNG

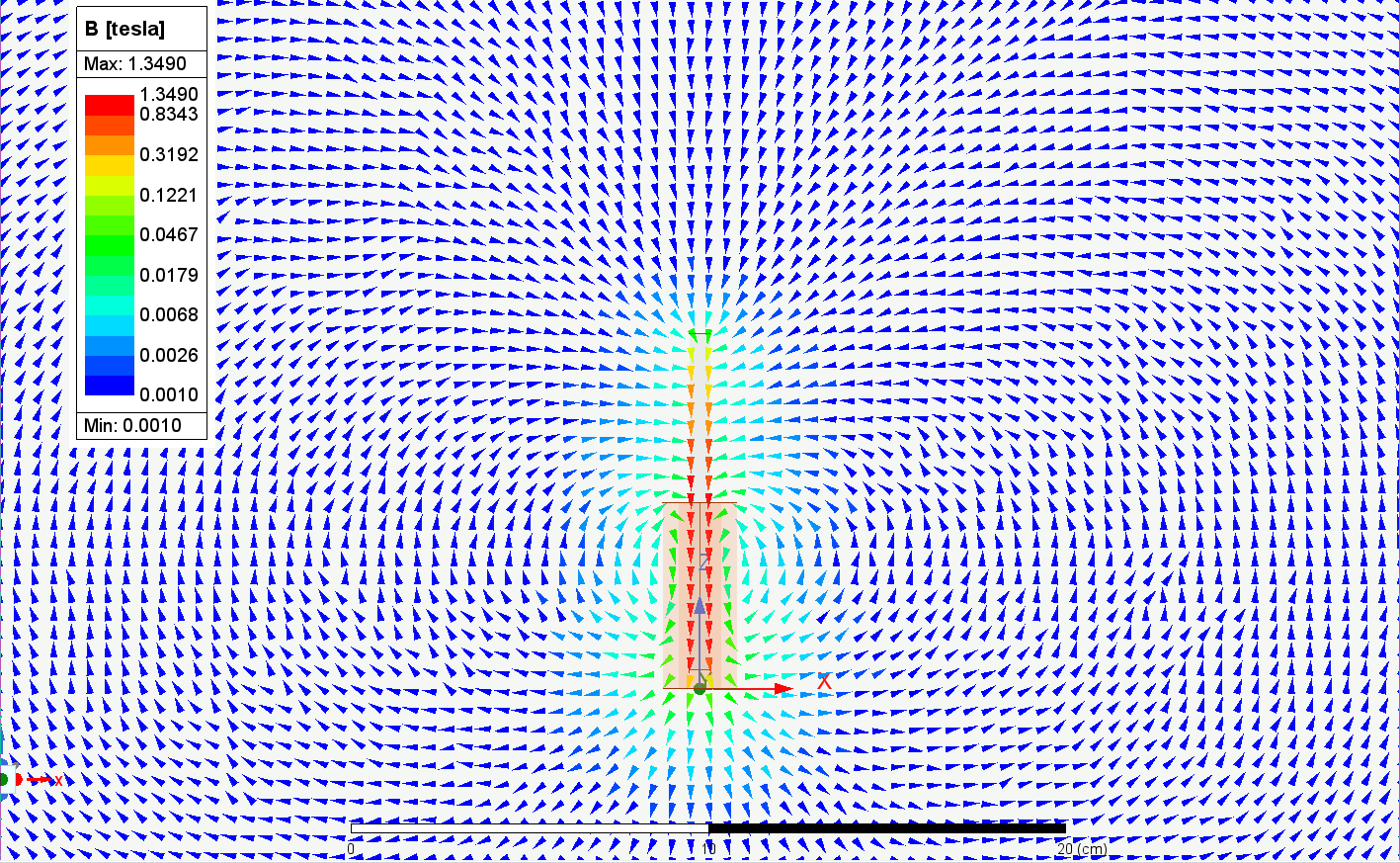
Simulaciones/Results/Pics/fields1.PNG
