promerogomb/Lanzadera-Electromagnetica/Simulaciones/Results/Pics/fields3.PNG

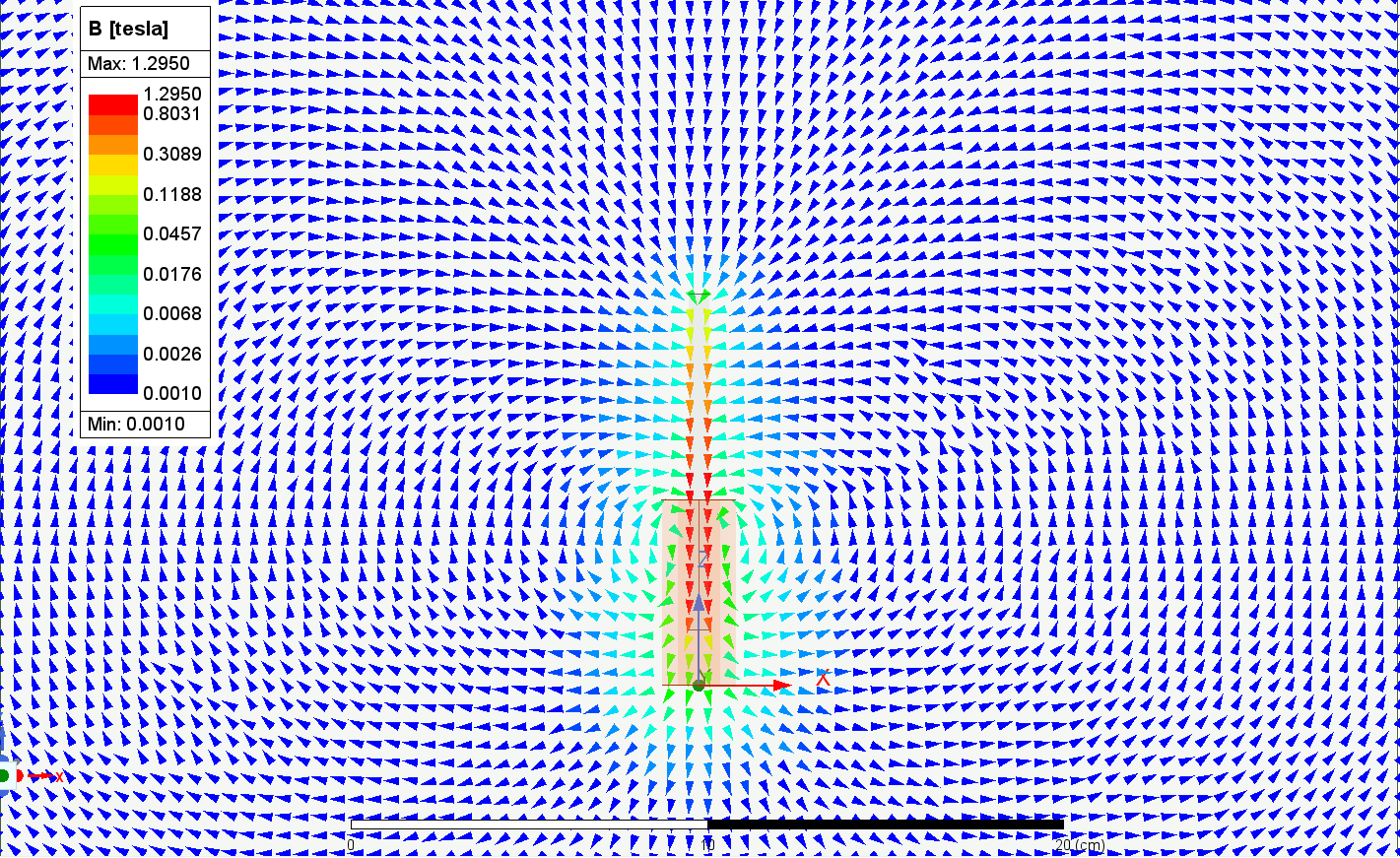
Simulaciones/Results/Pics/fields3.PNG
