promerogomb/Lanzadera-Electromagnetica/Simulaciones/Results/Pics/fields4.PNG

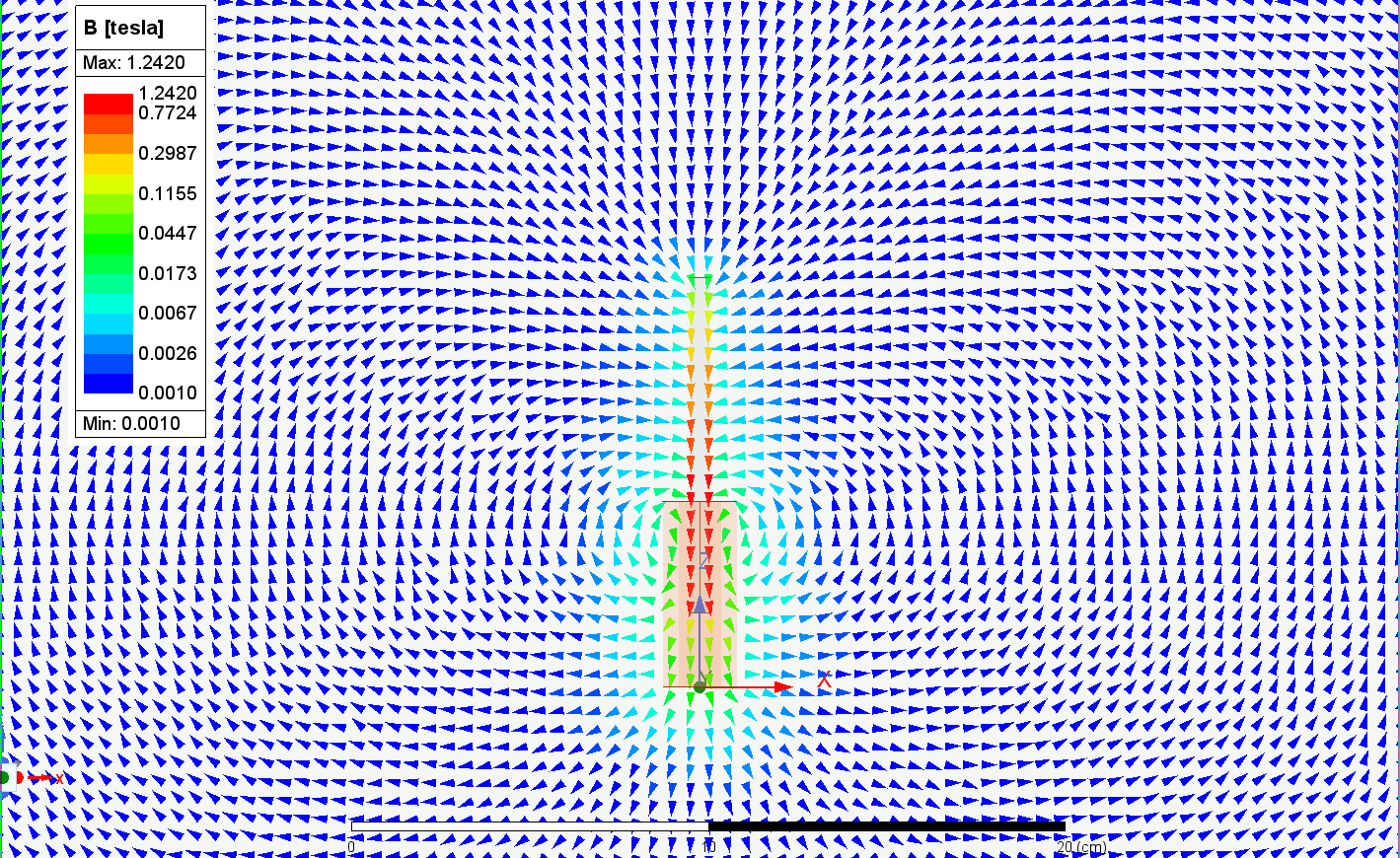
Simulaciones/Results/Pics/fields4.PNG
