promerogomb/Lanzadera-Electromagnetica/Simulaciones/Results/Pics/fields5.PNG

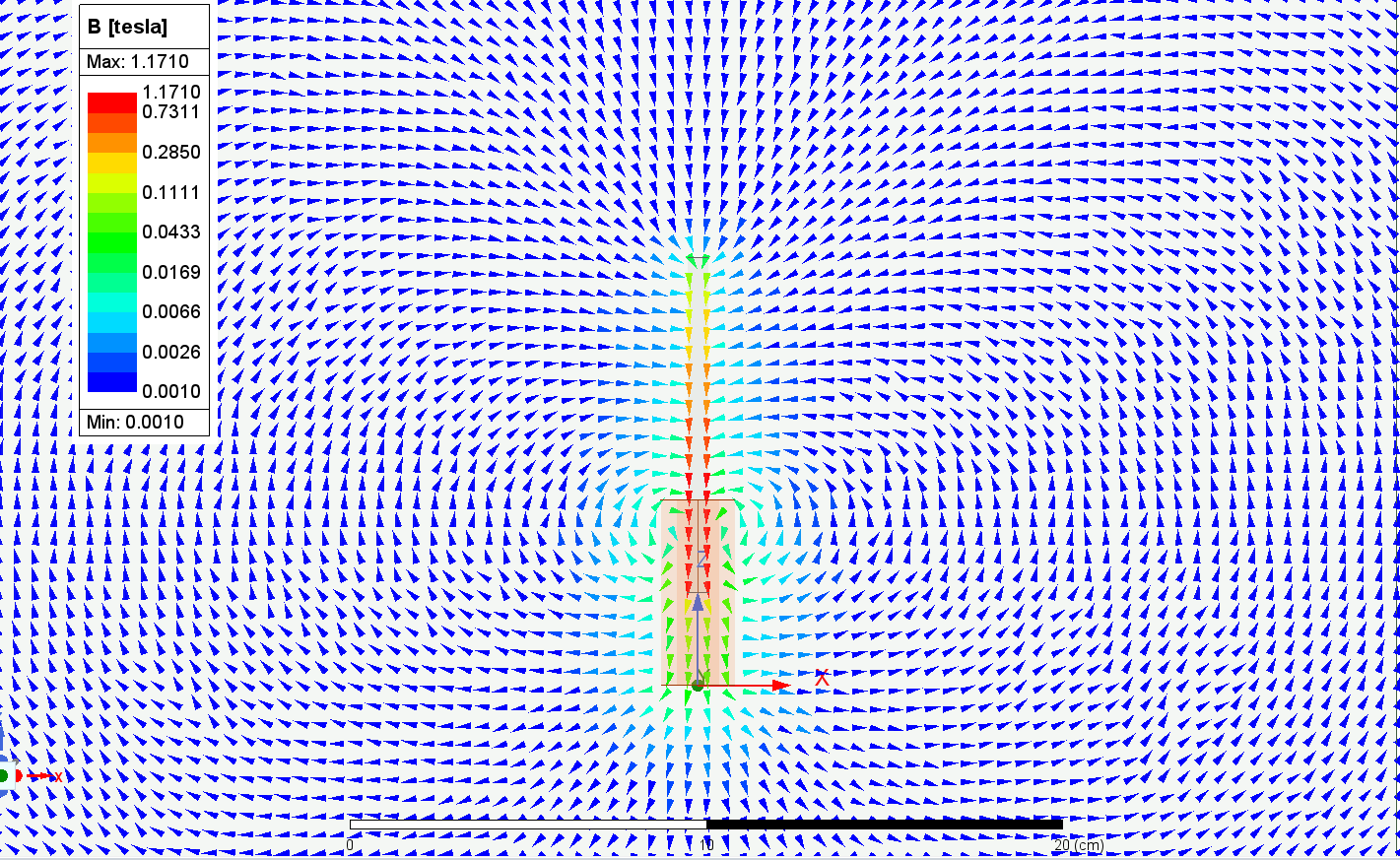
Simulaciones/Results/Pics/fields5.PNG
