promerogomb/Lanzadera-Electromagnetica/Simulaciones/Results/Pics/fields6.PNG

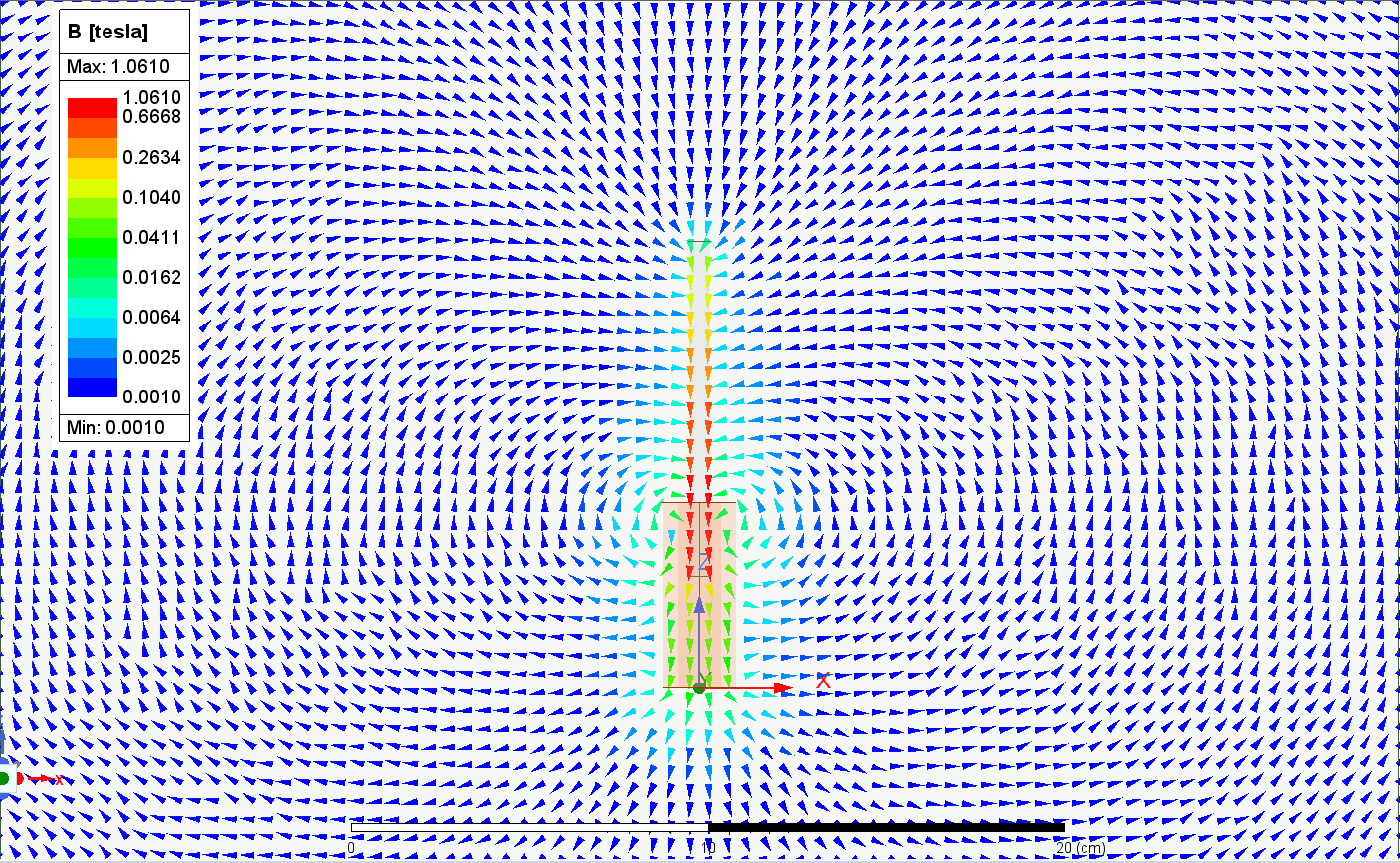
Simulaciones/Results/Pics/fields6.PNG
