promerogomb/Lanzadera-Electromagnetica/Simulaciones/Results/Pics/fields10.PNG

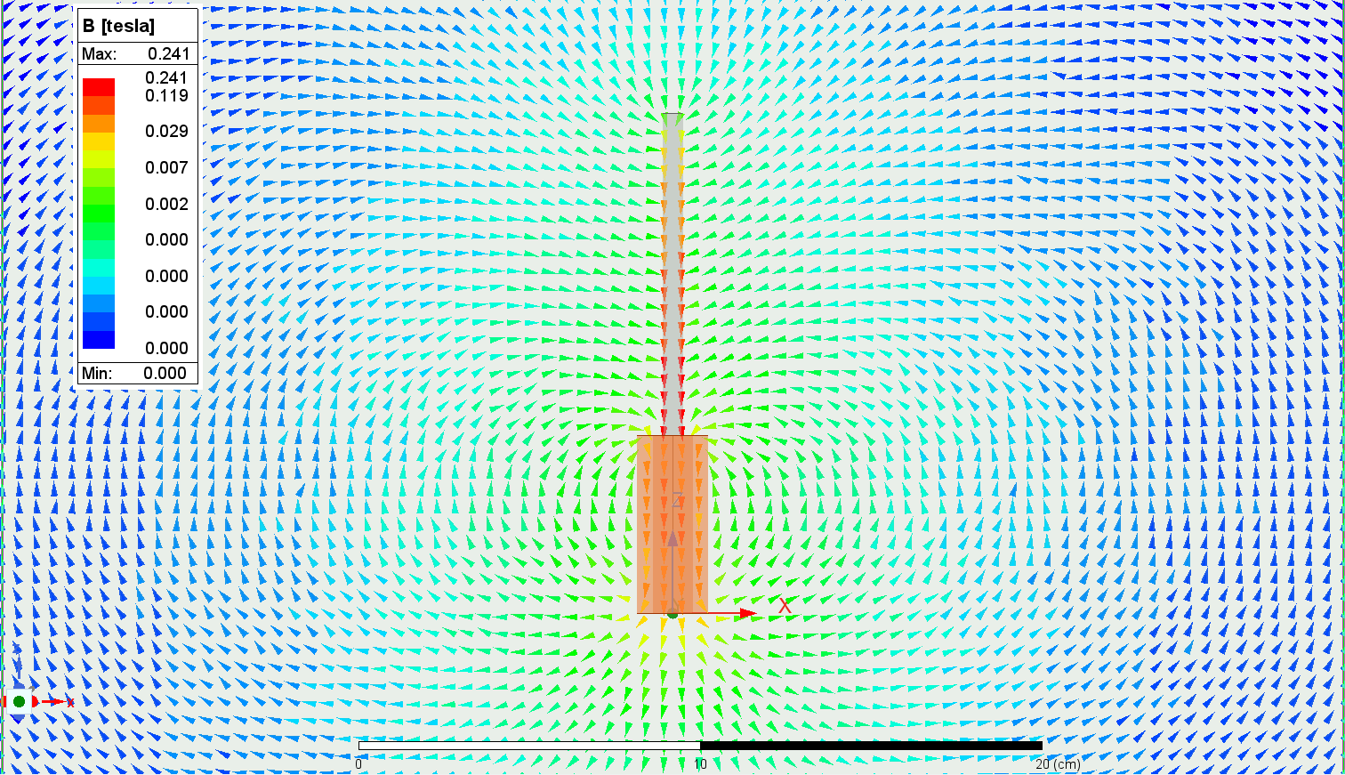
Simulaciones/Results/Pics/fields10.PNG
