promerogomb/Lanzadera-Electromagnetica/Simulaciones/Results/Pics/fields-1.PNG

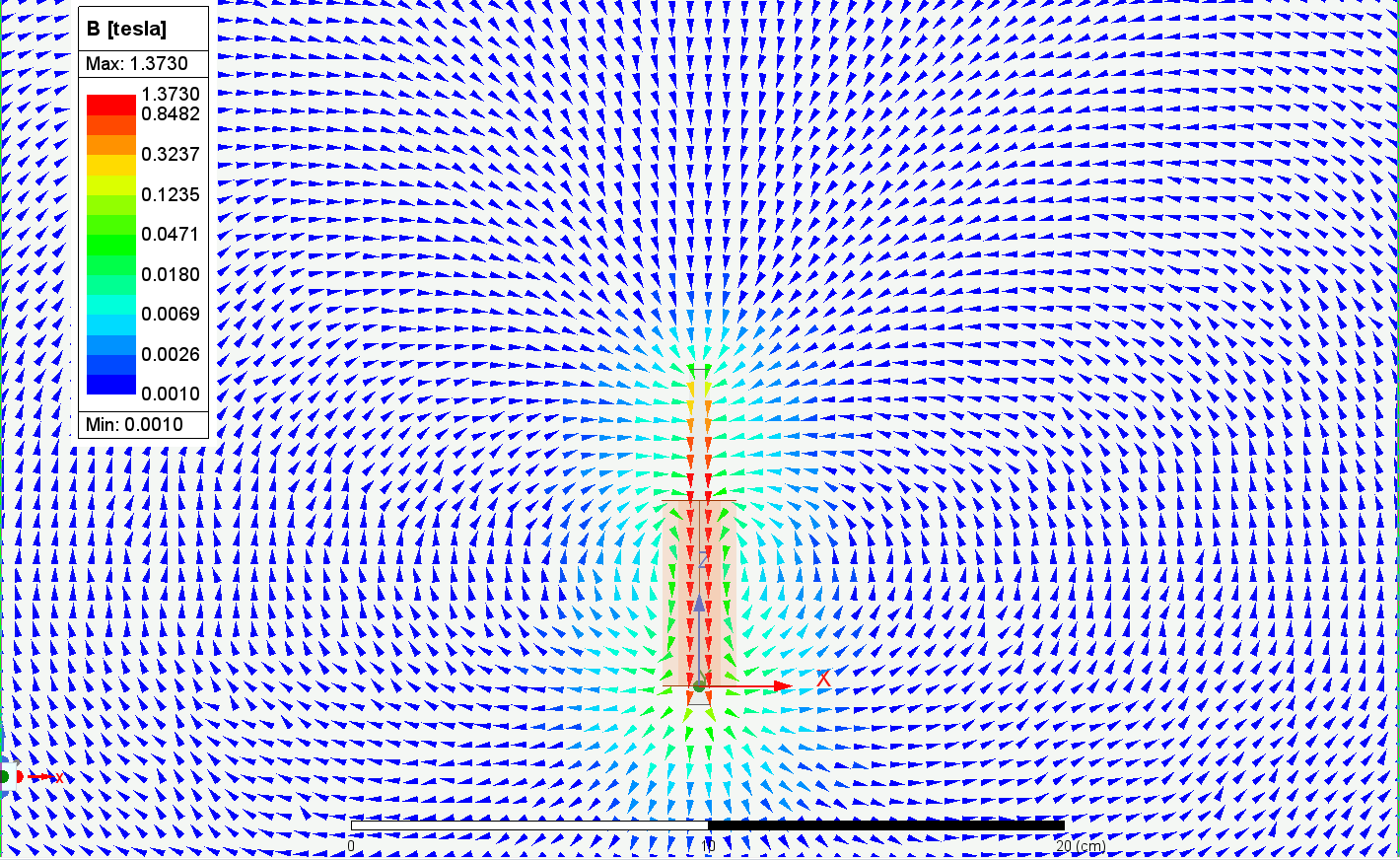
Simulaciones/Results/Pics/fields-1.PNG
