promerogomb/Lanzadera-Electromagnetica/Simulaciones/Results/Pics/fields.PNG

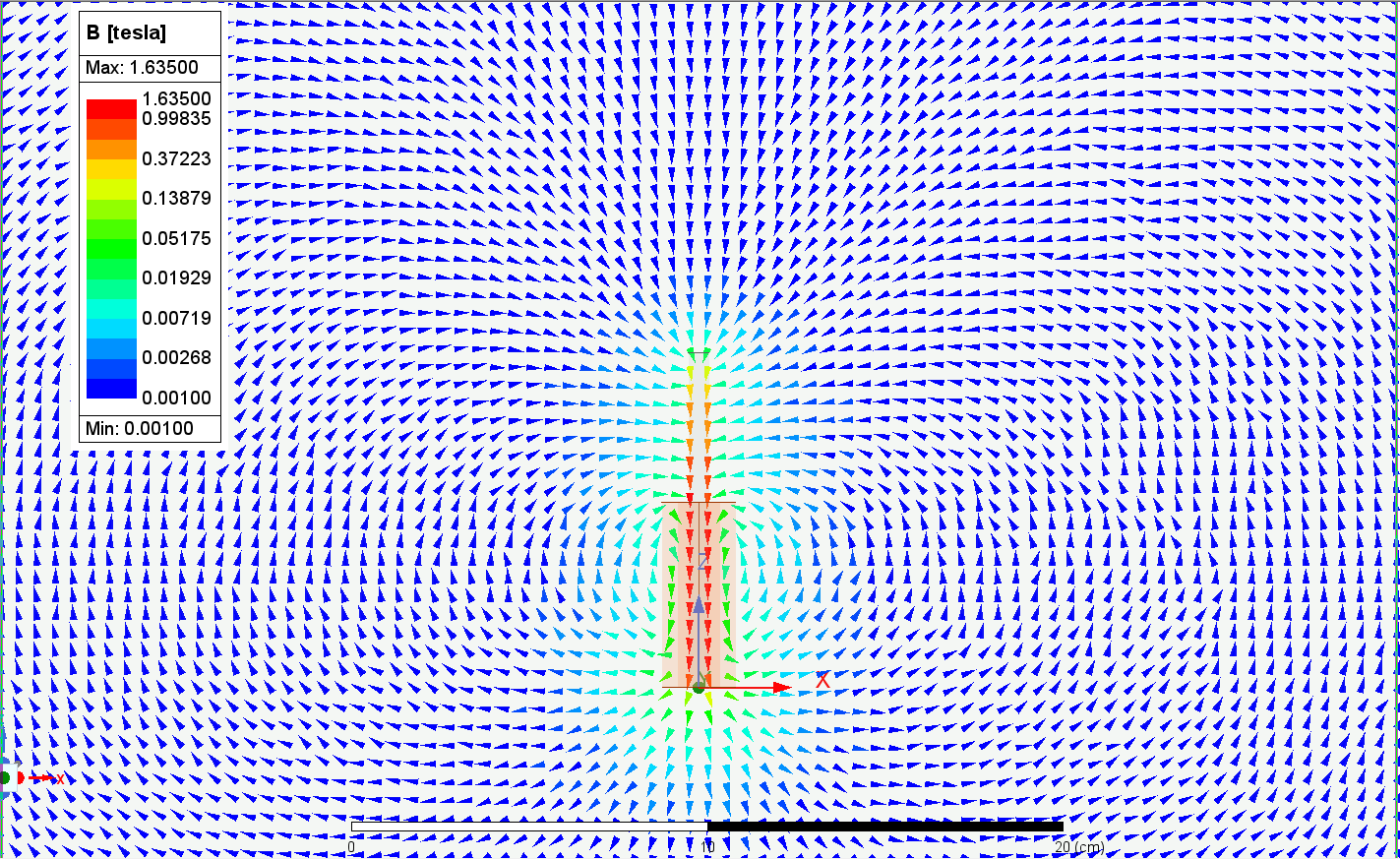
Simulaciones/Results/Pics/fields.PNG
