promerogomb/Lanzadera-Electromagnetica/Desarrollo analítico/PFG.pdf

F

## I Bu

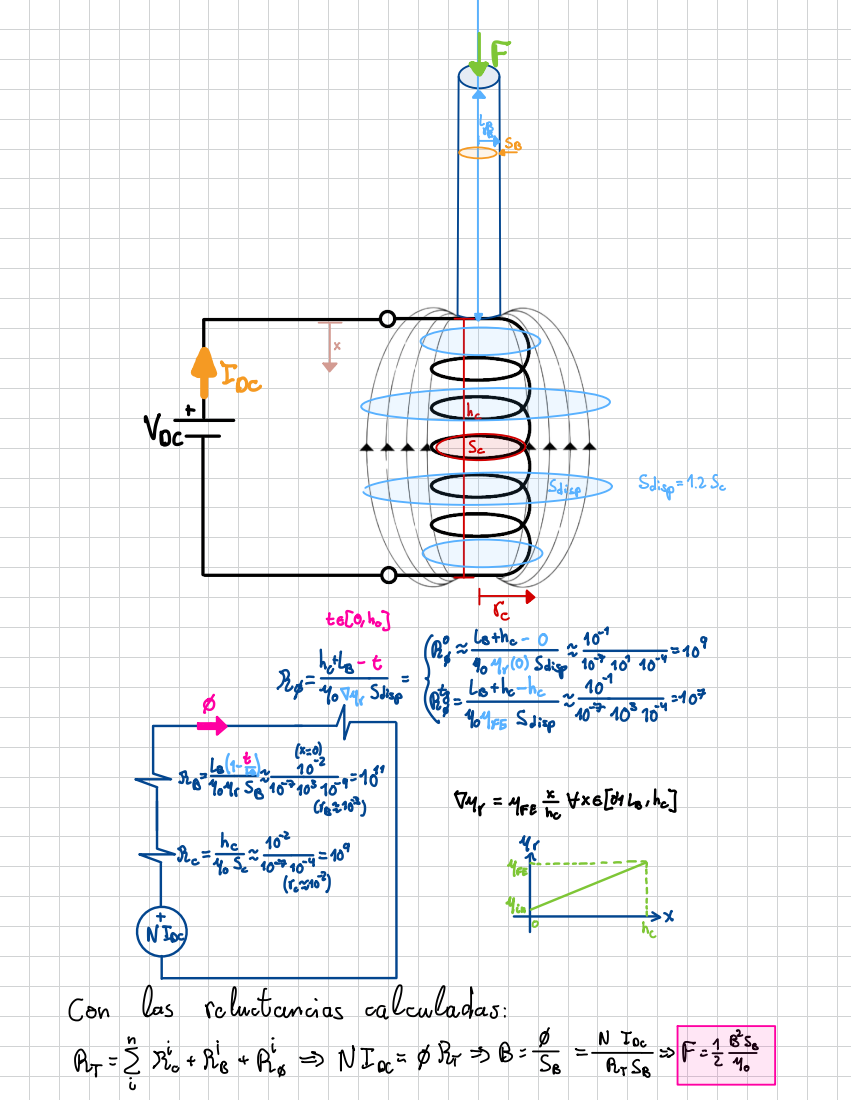
[picture p77: page 1]
Alpc; Voc; -disp; Sdisp =; telo,ha]; Lithc -; hothi -E; Ro %0 Mu(0) Scisp; %0 y Sdisp; ptglth-ho el by; Lis(1-Er); MFeXxe[1La,ha]; MEE⁻⁻⁻⁻⁻⁻⁻⁻⁻⁻⁻⁻; Min; NID; Con; las; reluctancias; calculadas :; + RENIx=1 = B =; =FBs
