promerogomb/Lanzadera-Electromagnetica/Desarrollo analítico/Circuito magnético esquema/CircuitoMag/CircuitoMag.kicad_pcb

## KiCad design tachometer.kicad_sch

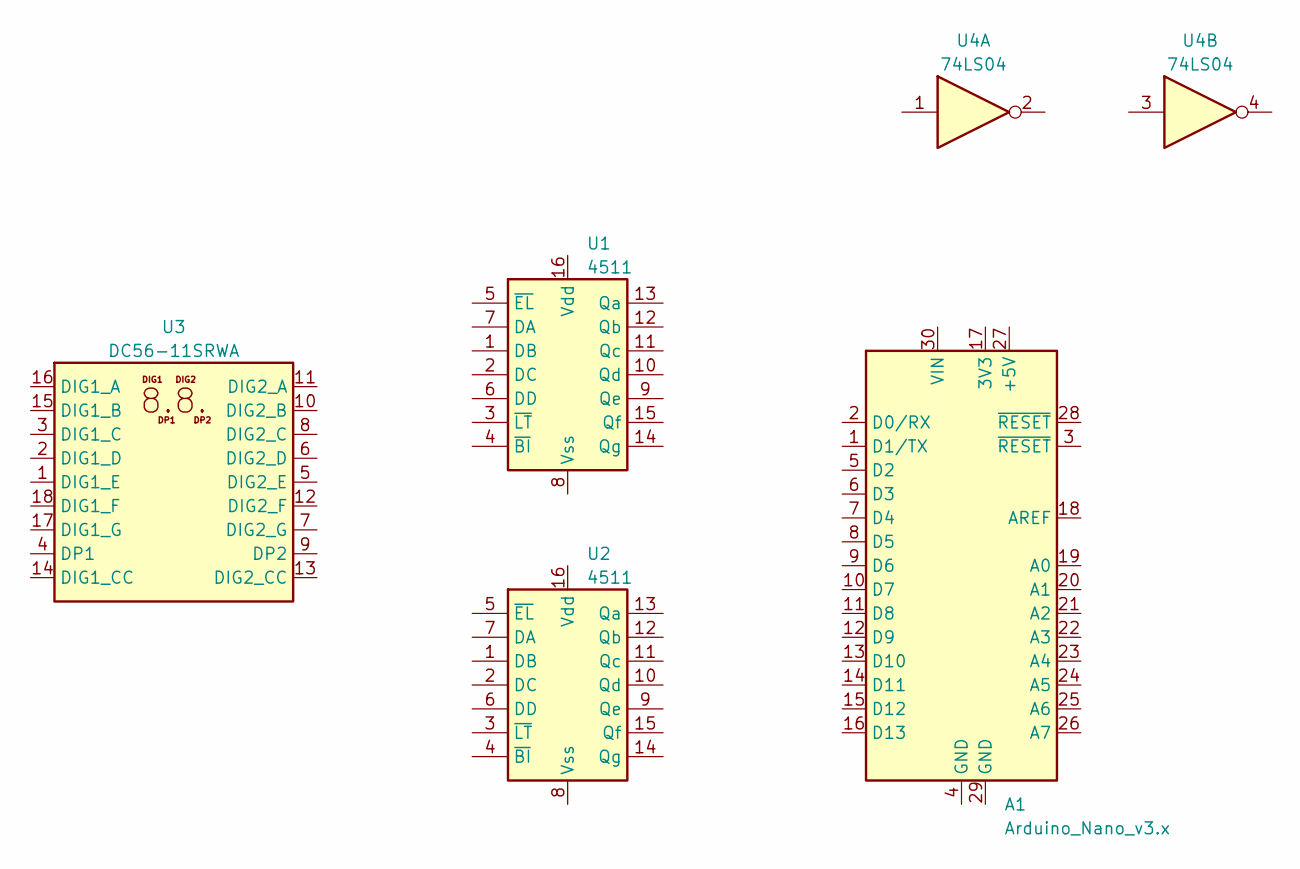
[picture p78: schematic tachometer.kicad_sch]

Parts:
A1: Arduino_Nano_v3.x; Arduino_Nano
U1, U2: 4511
U3: DC56-11SRWA; DA56-11SURKWA
U4: 74LS04
