promerogomb/Lanzadera-Electromagnetica/(commit log)

2024-05-20 Documento de setups
2024-05-21 Actualización PCB
    [PCB-B_Cu.gbr, PCB-B_Mask.gbr, PCB-B_Paste.gbr, PCB-B_Silkscreen.gbr, PCB-Edge_Cuts.gbr, PCB-F_Cu.gbr, PCB-F_Mask.gbr, PCB-F_Paste.gbr]
2024-05-24 Actualización gerbers PCB
    [PCB-B_Cu.gbr, PCB-B_Mask.gbr, PCB-B_Paste.gbr, PCB-B_Silkscreen.gbr, PCB-Edge_Cuts.gbr, PCB-F_Cu.gbr, PCB-F_Mask.gbr, PCB-F_Paste.gbr]
2024-05-26 Reorganización
    [Bobinas.xlsx, Fuerza experimental.xlsx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]
2024-06-15 Analitico Definitivo
    [CircuitoMag.kicad_pcb, CircuitoMag.kicad_sch]
2024-07-09 Big push
    Cambio en la distribución
    Prototipo terminado
    [PCB.kicad_sch]
